Sierra-Lobo/mtdb-hw/revA/doc/mtdc-revA-pcb-bot.JPG

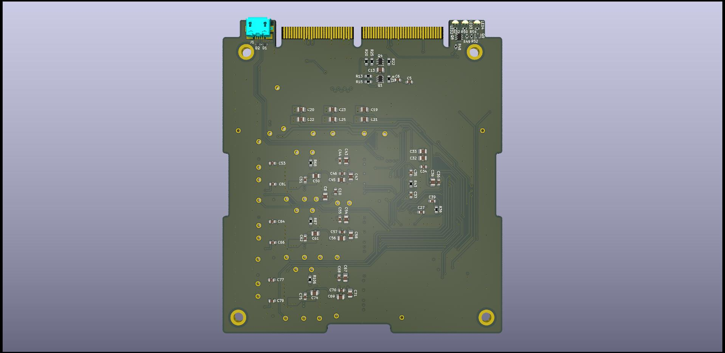
revA/doc/mtdc-revA-pcb-bot.JPG
