Sierra-Lobo/mtdb-hw/revA/doc/mtdc-revA-bom.xlsx

Item | Qty | Reference(s) | Value | DNP | Description | Manufacturer | Mfr. Part No | LibPart | Footprint | Datasheet
1 | 35 | C1, C2, C3, C4, C5, C6, C9, C10, C12, C14, C15, C27, C30, C31, C34, C35, C36, C37, C39, C42, C44, C51, C53, C55, C62, C64, C65, C66, C68, C75, C77, C78, C79, C80, C81 | 0.1uF |  | CAP CER 0.1UF 50V X7R 0603 | TDK Corporation | CGA3E2X7R1H104K080AE | Device:C | Capacitor_SMD:C_0603_1608Metric | https://product.tdk.com/en/system/files
2 | 13 | C7, C8, C19, C20, C21, C22, C23, C24, C25, C33, C50, C61, C74 | 1uF |  | CAP CER 1UF 50V X7R 0805 | TDK Corporation | CGA4J3X7R1H105K125AE | Device:C | Capacitor_SMD:C_0805_2012Metric | https://product.tdk.com/en/system/files
3 | 10 | C11, C13, C26, C32, C38, C40, C41, C43, C54, C67 | 10uF |  | CAP CER 10UF 25V X7S 0805 | TDK Corporation | CGA4J1X7S1E106K125AE | Device:C | Capacitor_SMD:C_0805_2012Metric | https://product.tdk.com/en/system/files
4 | 1 | C16 | 47uF |  | CAP CER 47UF 25V X5R 1206 | TDK | C3216X5R1E476M160AC | Device:C | Capacitor_SMD:C_1206_3216Metric | https://product.tdk.com/system/files/dam/doc/product/capacitor/ceramic/mlcc/catalog/mlcc_commercial_general_en.pdf
5 | 2 | C17, C18 | 47uF |  | CAP TANT 47UF 10% 16V 2917 | Vishay Sprague | TH3D476K016C0600 | Device:C_Polarized_US | Capacitor_Tantalum_SMD:CP_EIA-7343-43_Kemet-X | https://www.vishay.com/docs/40084/th3.pdf
6 | 2 | C28, C29 | 8pF |  | CAP CER 8PF 50V NP0 0402 | TDK Corporation | CGA2B2NP01H080D050BA | Device:C | Capacitor_SMD:C_0402_1005Metric | https://product.tdk.com/en/system/files
7 | 3 | C45, C56, C69 | 10uF | DNP | CAP CER 10UF 25V X7S 0805 | TDK Corporation | CGA4J1X7S1E106K125AE | Device:C | Capacitor_SMD:C_0805_2012Metric | https://product.tdk.com/en/system/files
8 | 3 | C46, C57, C70 | 0.1uF | DNP | CAP CER 0.1UF 50V X7R 0603 | TDK Corporation | CGA3E2X7R1H104K080AE | Device:C | Capacitor_SMD:C_0603_1608Metric | https://product.tdk.com/en/system/files
9 | 3 | C47, C58, C71 | 1uF | DNP | CAP CER 1UF 50V X7R 0805 | TDK Corporation | CGA4J3X7R1H105K125AE | Device:C | Capacitor_SMD:C_0805_2012Metric | https://product.tdk.com/en/system/files
10 | 6 | C48, C52, C59, C63, C72, C76 | 22uF |  | CAP CER 22UF 16V X7R 1210 | TDK Corporation | CGA6P1X7R1C226M250AC | Device:C | Capacitor_SMD:C_1210_3225Metric | https://product.tdk.com/system/files/dam/doc/product/capacitor/ceramic/mlcc/catalog/mlcc_automotive_general_en.pdf
11 | 3 | C49, C60, C73 | 100pF |  | CAP CER 100PF 50V NP0 0603 | TDK Corporation | CGA3E2C0G1H101J080AE | Device:C | Capacitor_SMD:C_0603_1608Metric | https://product.tdk.com/en/system/files
12 | 2 | D1, D2 | ESD321DPYR |  | TVS DIODE 3.6VWM 6.8VC 2X1SON | Texas Instruments | ESD321DPYR | Device:D_Zener | SierraLobo:D_0402_1005Metric | https://www.ti.com/general/docs/suppproductinfo.tsp?distId=10
13 | 2 | D3, D4 | 1N4148W-13-F |  | DIODE GEN PURP 100V 300MA SOD123 | Diodes Incorporated | 1N4148W-13-F | Device:D | Diode_SMD:D_SOD-123 | https://www.diodes.com/assets/Datasheets/BAV16W_1N4148W.pdf
14 | 1 | D5 | SK6812MINI |  | ADDRESS LED DISC SERIAL RGB 1=10 | Adafruit Industries LLC | 2659 | LED:SK6812MINI | LED_SMD:LED_SK6812MINI_PLCC4_3.5x3.5mm_P1.75mm | https://cdn-shop.adafruit.com/product-files/2686/SK6812MINI_REV.01-1-2.pdf
16 | 1 | J1 | ZX62-AB-5PA(31) |  | CONN RCPT USB2.0 MICRO AB SMD RA | Hirose Electric | ZX62-AB-5PA(31) | Connector:USB_B_Micro | SierraLobo:ZX62-AB-5PA(31) | https://www.hirose.com/product/document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
17 | 6 | J2, J3, J4, J5, J6, J7 | T1M-02-F-SH-L |  | CONN HEADER SMD R/A 2POS 1MM | Samtec | T1M-02-F-SH-L-K | Connector_Generic:Conn_01x02 | SierraLobo:SAMTEC_T1M-02-F-SH-L-K | https://suddendocs.samtec.com/prints/t1m-xx-x-sh-l-x-xx-mkt.pdf
18 | 1 | JP1 | Wire Cut Jumper |  | 26 AWG SOLID CORE WIRE | N/A | N/A | Jumper:Jumper_2_Bridged | Resistor_SMD:R_0603_1608Metric | ~
19 | 1 | L1 | 10uH |  | FIXED IND WW SHEILD 10UH 1.72A 230MOHM 1210 | TDK | BCL322520RT-100M-D | Device:L | Inductor_SMD:L_1210_3225Metric | https://product.tdk.com/system/files/dam/doc/product/inductor/inductor/smd/catalog/inductor_automotive_power_bcl322520rt-d_en.pdf
20 | 3 | L2, L3, L4 | 2.2uH |  | FIXED IND 2.2UH 6.6A 26MOHM SMD | Vishay Dale | IHLP2020CZER2R2M8A | Device:L | SierraLobo:L_Vishay_IHLP-2020 | https://www.vishay.com/docs/34563/ihlp-2020cz-8a.pdf
21 | 1 | LED1 | GREEN |  | LED GREEN CLEAR SMD R/A | Kingbright | APA2107CGCK | Device:D | SierraLobo:APA2107x | https://www.kingbrightusa.com/images/catalog/SPEC/APA2107CGCK.pdf
22 | 1 | LED2 | ORANGE |  | LED ORANGE CLEAR SMD R/A | Kingbright | APA2107SECK | Device:D | SierraLobo:APA2107x | https://www.kingbrightusa.com/images/catalog/SPEC/APA2107SECK.pdf
23 | 1 | LED3 | YELLOW |  | LED YELLOW CLEAR SMD R/A | Kingbright | APA2107SYCK | Device:D | SierraLobo:APA2107x | https://www.kingbrightusa.com/images/catalog/SPEC/APA2107SYCK.pdf
24 | 1 | LED4 | RED |  | LED RED CLEAR SMD R/A | Kingbright | APA2107LSECK/J3-PRV | Device:D | SierraLobo:APA2107x | https://www.kingbrightusa.com/images/catalog/SPEC/APA2107LSECK-J3-PRV.pdf
25 | 3 | NTC1, NTC2, NTC3 | 10k |  | THERMISTOR NTC 10KOHM 3976K BEAD | TE | GA10K3A1AM | Device:Thermistor_NTC_US |  | https://www.te.com/usa-en/product-GA10K3A1AM.datasheet.pdf
26 | 1 | P2 | Conn_01x06 |  | CONN HEADER SMD 36POS 2.54MM | Samtec | TSM-136-01-L-SV | Connector_Generic:Conn_01x06 | Connector_PinHeader_2.54mm:PinHeader_1x06_P2.54mm_Vertical_SMD_Pin1Right | https://suddendocs.samtec.com/catalog_english/tsm.pdf
27 | 1 | P3 | Conn_02x03_Odd_Even |  | CONN HEADER SMD 52POS 2.54MM | Samtec | TSM-126-02-L-DV-P-TR | Connector_Generic:Conn_02x03_Odd_Even | Connector_PinHeader_2.54mm:PinHeader_2x03_P2.54mm_Vertical_SMD | https://suddendocs.samtec.com/catalog_english/tsm.pdf
28 | 1 | P4 | FTSH-105-01-F-DV-K-TR |  | CONN HEADER SMD 10POS 1.27MM | Samtec | FTSH-105-01-F-DV-K-TR | Connector_Generic:Conn_02x05_Odd_Even | Connector_PinHeader_1.27mm:PinHeader_2x05_P1.27mm_Vertical_SMD | https://suddendocs.samtec.com/catalog_english/ftsh_smt.pdf
29 | 4 | Q1, Q4, Q7, Q8 | MMDT2222A |  | TRANS 2NPN 40V 0.6A SOT363 | Diodes Incorporated | MMDT2222A-7-F | SierraLobo:MMDT2222 | Package_TO_SOT_SMD:SOT-363_SC-70-6 | https://www.diodes.com/assets/Datasheets/ds30125.pdf
30 | 1 | Q2 | IRLML2803 |  | MOSFET N-CH 30V 1.2A SOT23 | Infineon | IRLML2803TRPBF | Device:Q_NMOS_GSD | Package_TO_SOT_SMD:SOT-23 | https://www.infineon.com/dgdl/irlml2803pbf.pdf?fileId=5546d462533600a4015356682aff260f
31 | 1 | Q3 | MMBT4401WT1G |  | TRANS NPN 40V 0.6A SC70-3 | onsemi | TRANS NPN 40V 0.6A SC70-3 | Device:Q_NPN_BEC | Package_TO_SOT_SMD:SOT-323_SC-70 | https://www.onsemi.com/pdf/datasheet/mmbt4401wt1-d.pdf
32 | 2 | Q5, Q6 | BSZ180 |  | MOSFET P-CH 30V 9A/39.6A TSDSON | Infineon | BSZ180P03NS3GATMA1 | SierraLobo:BSZ086 | SierraLobo:PG-TSDSON-8_3.3x3.3mm | https://www.infineon.com/dgdl/Infineon-BSZ180P03NS3_G-DS-v02_01-en.pdf?fileId=db3a304326dfb13001271f04398f4ec1
33 | 1 | Q9 | MMBT3906T |  | TRANS PNP 40V 0.2A SOT523 | Diodes Incorporated | MMBT3906T-7-F | Device:Q_PNP_BEC | Package_TO_SOT_SMD:SOT-523 | https://www.diodes.com/assets/Datasheets/ds30271.pdf
34 | 10 | R1, R4, R44, R46, R64, R69, R83, R88, R102, R107 | 0 |  | RES 0 OHM JUMPER 1/10W 0603 | Stackpole Electronics Inc | RMCF0603ZT0R00 | Device:R_US | Resistor_SMD:R_0603_1608Metric | https://www.seielect.com/Catalog/SEI-RMCF_RMCP.pdf
35 | 5 | R2, R3, R65, R84, R103 | 0 | DNP | RES 0 OHM JUMPER 1/10W 0603 | Stackpole Electronics Inc | RMCF0603ZT0R00 | Device:R_US | Resistor_SMD:R_0603_1608Metric | https://www.seielect.com/Catalog/SEI-RMCF_RMCP.pdf
36 | 26 | R5, R6, R16, R23, R24, R45, R47, R51, R59, R60, R61, R71, R72, R73, R78, R79, R80, R90, R91, R92, R97, R98, R99, R109, R110, R111 | 1k |  | RES 1K OHM 1% 1/10W 0603 | Stackpole Electronics Inc | RMCF0603FG1K00 | Device:R_US | Resistor_SMD:R_0603_1608Metric | https://www.seielect.com/Catalog/SEI-RMCF_RMCP.pdf
37 | 2 | R7, R8 | 220 |  | RES 220 OHM 1% 1/10W 0603 | Stackpole Electronics Inc | RMCF0603FT220R | Device:R_US | Resistor_SMD:R_0603_1608Metric | https://www.seielect.com/Catalog/SEI-RMCF_RMCP.pdf
38 | 19 | R9, R14, R15, R17, R18, R22, R43, R66, R67, R68, R70, R85, R86, R87, R89, R104, R105, R106, R108 | 100k |  | RES 100K OHM 1% 1/10W 0603 | Stackpole Electronics Inc | RMCF0603FT100K | Device:R_US | Resistor_SMD:R_0603_1608Metric | https://www.seielect.com/Catalog/SEI-RMCF_RMCP.pdf
39 | 16 | R10, R11, R12, R13, R19, R26, R27, R34, R36, R37, R40, R41, R42, R62, R81, R100 | 10k |  | RES 10K OHM 1% 1/10W 0603 | Stackpole Electronics Inc | RMCF0603FT10K0 | Device:R_US | Resistor_SMD:R_0603_1608Metric | https://www.seielect.com/Catalog/SEI-RMCF_RMCP.pdf
40 | 1 | R20 | 200k |  | RES 200K OHM 1% 1/10W 0603 | Stackpole Electronics Inc | RMCF0603FT200K | Device:R_US | Resistor_SMD:R_0603_1608Metric | https://www.seielect.com/Catalog/SEI-RMCF_RMCP.pdf
41 | 1 | R21 | 20k |  | RES 20K OHM 1% 1/10W 0603 | Stackpole Electronics Inc | RMCF0603FT20K0 | Device:R_US | Resistor_SMD:R_0603_1608Metric | https://www.seielect.com/Catalog/SEI-RMCF_RMCP.pdf
42 | 1 | R25 | 73.2k |  | RES 73.2K OHM 1% 1/10W 0603 | Stackpole Electronics Inc | RMCF0603FT73K2 | Device:R_US | Resistor_SMD:R_0603_1608Metric | https://www.seielect.com/Catalog/SEI-RMCF_RMCP.pdf
43 | 1 | R28 | 12.4k |  | RES 12.4K OHM 1% 1/10W 0603 | Stackpole Electronics Inc | RMCF0603FT12K4 | Device:R_US | Resistor_SMD:R_0603_1608Metric | https://www.seielect.com/Catalog/SEI-RMCF_RMCP.pdf
44 | 1 | R29 | 4.12k |  | RES 4.12K OHM 1% 1/10W 0603 | Stackpole Electronics Inc | RMCF0603FT4K12 | Device:R_US | Resistor_SMD:R_0603_1608Metric | https://www.seielect.com/Catalog/SEI-RMCF_RMCP.pdf
45 | 4 | R30, R32, R50, R54 | 1.5k |  | RES 1.5K OHM 1% 1/16W 0402 | Stackpole Electronics Inc | RMCF0402FT1K50 | Device:R_US | Resistor_SMD:R_0402_1005Metric | https://www.seielect.com/Catalog/SEI-RMCF_RMCP.pdf
46 | 5 | R31, R33, R48, R49, R52 | 10k |  | RES 10K OHM 1% 1/16W 0402 | Stackpole Electronics Inc | RMCF0402FT10K0 | Device:R_US | Resistor_SMD:R_0402_1005Metric | https://www.seielect.com/Catalog/SEI-RMCF_RMCP.pdf
47 | 1 | R35 | 330 |  | RES 330 OHM 1% 1/10W 0603 | Stackpole Electronics Inc | RMCF0603FT330R | Device:R_US | Resistor_SMD:R_0603_1608Metric | https://www.seielect.com/Catalog/SEI-RMCF_RMCP.pdf
48 | 1 | R38 | 330k |  | RES 330K OHM 1% 1/10W 0603 | Stackpole Electronics Inc | RMCF0603FT330K | Device:R_US | Resistor_SMD:R_0603_1608Metric | https://www.seielect.com/Catalog/SEI-RMCF_RMCP.pdf
49 | 1 | R39 | 110k |  | RES 110K OHM 1% 1/10W 0603 | Stackpole Electronics Inc | RMCF0603FT110K | Device:R_US | Resistor_SMD:R_0603_1608Metric | https://www.seielect.com/Catalog/SEI-RMCF_RMCP.pdf
50 | 4 | R53, R63, R82, R101 | 10k | DNP | RES 10K OHM 1% 1/10W 0603 | Stackpole Electronics Inc | RMCF0603FT10K0 | Device:R_US | Resistor_SMD:R_0603_1608Metric | https://www.seielect.com/Catalog/SEI-RMCF_RMCP.pdf
51 | 2 | R55, R74 | 300mR |  | RES 0.3 OHM 1% 1/4W 0805 | Vishay Dale | RCWE0805R300FKEA | Device:R_US | Resistor_SMD:R_0805_2012Metric | https://www.vishay.com/docs/20019/rcwe.pdf
52 | 9 | R56, R57, R58, R75, R76, R77, R94, R95, R96 | 1k | DNP | RES 1K OHM 1% 1/10W 0603 | Stackpole Electronics Inc | RMCF0603FG1K00 | Device:R_US | Resistor_SMD:R_0603_1608Metric | https://www.seielect.com/Catalog/SEI-RMCF_RMCP.pdf
53 | 1 | R93 | 100mR |  | RES 0.1 OHM 1% 1/4W 0805 | Vishay Dale | RCWE0805R100FKEA | Device:R_US | Resistor_SMD:R_0805_2012Metric | https://www.vishay.com/docs/20019/rcwe.pdf
54 | 1 | SW1 | KMR231NG LFS |  | SWITCH TACTILE SPST-NO 0.05A 32V | C&K | KMR231NG LFS | Switch:SW_SPST | SierraLobo:KMR2_4.6X2.8 | https://www.ckswitches.com/media/1479/kmr2.pdf
55 | 3 | TP1, TP2, TP3 | ${NET_NAME(1)} |  | PC TEST POINT MINIATURE | Keystone | 5027 | Connector:TestPoint | SierraLobo:Keystone_5027 | https://www.keyelco.com/userAssets/file/M65p55.pdf
56 | 35 | TP4, TP5, TP6, TP7, TP8, TP9, TP10, TP11, TP12, TP13, TP14, TP15, TP16, TP17, TP18, TP19, TP20, TP21, TP22, TP23, TP24, TP25, TP26, TP27, TP28, TP29, TP30, TP31, TP32, TP33, TP34, TP35, TP36, TP37, TP38 | ${NET_NAME(1)} |  | PC TEST POINT MINIATURE PURPLE | Keystone | 5119 | Connector:TestPoint | SierraLobo:TestPoint_Keystone_5000-5004_Miniature | https://www.keyelco.com/userAssets/file/M65p56.pdf
57 | 2 | U1, U2 | 74LVC1G17 |  | IC BUF NON-INVERT 5.5V SC70-5 | Texas Instruments | SN74LVC1G17QDCKRQ1 | SierraLobo:74LVC1G17 | Package_TO_SOT_SMD:SOT-353_SC-70-5 | https://www.ti.com/lit/ds/symlink/sn74lvc1g17.pdf
58 | 2 | U3, U4 | MCP9700Ax-E/LT |  | SENSOR ANALOG -40C-125C SC70-5 | Microchip Technology | MCP9700AT-E/LT | SierraLobo:MCP9700Ax-E/LT | Package_TO_SOT_SMD:SOT-353_SC-70-5 | http://ww1.microchip.com/downloads/en/DeviceDoc/20001942G.pdf
59 | 1 | U5 | AP2161W |  | IC PWR SWITCH P-CHAN 1:1 SOT25 | Diodes Incorporated | AP2161W | Power_Management:AP2161W | Package_TO_SOT_SMD:SOT-23-5 | https://www.diodes.com/assets/Datasheets/AP2161.pdf
60 | 2 | U6, U7 | MCP1700T-33 |  | IC REG LINEAR 3.3V 250MA SOT89-3 | Microchip Technology | MCP1700T-3302E/MB | Regulator_Linear:MCP1700x-330xxMB | Package_TO_SOT_SMD:SOT-89-3 | http://ww1.microchip.com/downloads/en/DeviceDoc/20001826D.pdf
61 | 1 | U8 | MCP1700T-50 |  | IC REG LINEAR 5.0V 250MA SOT89-3 | Microchip Technology | MCP1700T-5002E/MB | Regulator_Linear:MCP1700x-330xxMB | Package_TO_SOT_SMD:SOT-89-3 | http://ww1.microchip.com/downloads/en/DeviceDoc/20001826D.pdf
62 | 1 | U9 | ATL431 |  | IC VREF SHUNT ADJ 0.5% SOT23-3 | Texas Instruments | ATL431BQDBZR | SierraLobo:ATL31BQDBZR | Package_TO_SOT_SMD:SOT-23 | https://www.ti.com/lit/ds/slvs555m/slvs555m.pdf?ts=1687216345649
63 | 1 | U10 | MAX708RESA+T |  | IC SUPERVISOR 1 CHANNEL 8SOIC | Analog Devices/Maxim Integrated | MAX708RESA+T | SierraLobo:MAX708RESA | Package_SO:SO-8_3.9x4.9mm_P1.27mm | https://www.analog.com/media/en/technical-documentation/data-sheets/max706ap-max708t.pdf
64 | 1 | U11 | MR25H10MDF |  | IC RAM 1MBIT SPI 40MHZ 8DFN | Everspin Technologies Inc. | MR25H10MDF | SierraLobo:MR25H10MDF | Package_DFN_QFN:DFN-8-1EP_6x5mm_P1.27mm_EP2x2mm | https://www.mouser.com/datasheet/2/144/MR25H10_Datasheet-1511337.pdf
65 | 1 | U12 | ATSAMD51J20A-AU |  | IC MCU 32BIT 1MB FLASH 64TQFP | Microchip Technology | ATSAMD51J20A-AU | SierraLobo:ATSAMD51J20A-AU | Package_QFP:TQFP-64_10x10mm_P0.5mm | http://ww1.microchip.com/downloads/en/DeviceDoc/60001507E.pdf
66 | 3 | U13, U17, U22 | DAC121S101Q |  | IC DAC 12BIT V-OUT TSOT23-6 | Texas Instruments | DAC121S101QCMK/NOPB | SierraLobo:DAC121S101Q | Package_TO_SOT_SMD:TSOT-23-6 | https://www.ti.com/lit/ds/symlink/dac121s101.pdf?HQS=dis-dk-null-digikeymode-dsf-pf-null-wwe&ts=1686947453484
67 | 3 | U14, U18, U23 | AD5270BRM | DNP | IC DGT RHE 100KOHM 1024TP 10MSOP | Analog Devices | AD5270BRMZ-100 | SierraLobo:AD5270BRM | Package_SO:MSOP-10_3x3mm_P0.5mm | https://www.analog.com/media/en/technical-documentation/data-sheets/AD5270_5271.pdf
68 | 3 | U15, U19, U24 | LTC3600 |  | IC REG BUCK PROG 1.5A 12MSOP | Analog Devices | LTC3600EMSE#TRPBF | SierraLobo:LTC3600EMSE | Package_SO:MSOP-12-1EP_3x4mm_P0.65mm_EP1.65x2.85mm | https://www.analog.com/media/en/technical-documentation/data-sheets/3600fd.pdf
69 | 3 | U16, U20, U25 | DRV8838 |  | IC BRIDGE DRIVER PAR 8WSON | Texas Instruments | DRV8838DSGT | SierraLobo:DRV8838DSGT | Package_SON:WSON-8-1EP_2x2mm_P0.5mm_EP0.9x1.6mm | https://www.ti.com/general/docs/suppproductinfo.tsp?distId=10
70 | 3 | U21, U26, U27 | INA199A2 |  | IC CURRENT SENSE 1.5% SC70-6 | Texas Instruments | INA199A2DCKT | Amplifier_Current:INA199xxDCK | Package_TO_SOT_SMD:SOT-363_SC-70-6 | http://www.ti.com/lit/ds/symlink/ina199.pdf
71 | 1 | Y1 | 32.768kHz |  | CRYSTAL 32.7680KHZ 12.5PF SMD | Abracon | ABS07AIG-32.768KHZ-1-T | Device:Crystal | SierraLobo:Crystal_SMD_3215-2Pin_3.2x1.5mm | https://abracon.com/datasheets/ABS07AIG.pdf
Total | 295 | 70 |  |  |  |  |  |  |  | 70
