Sierra-Lobo/mtdb-hw/revA/doc/mtdc-revA-sch.pdf

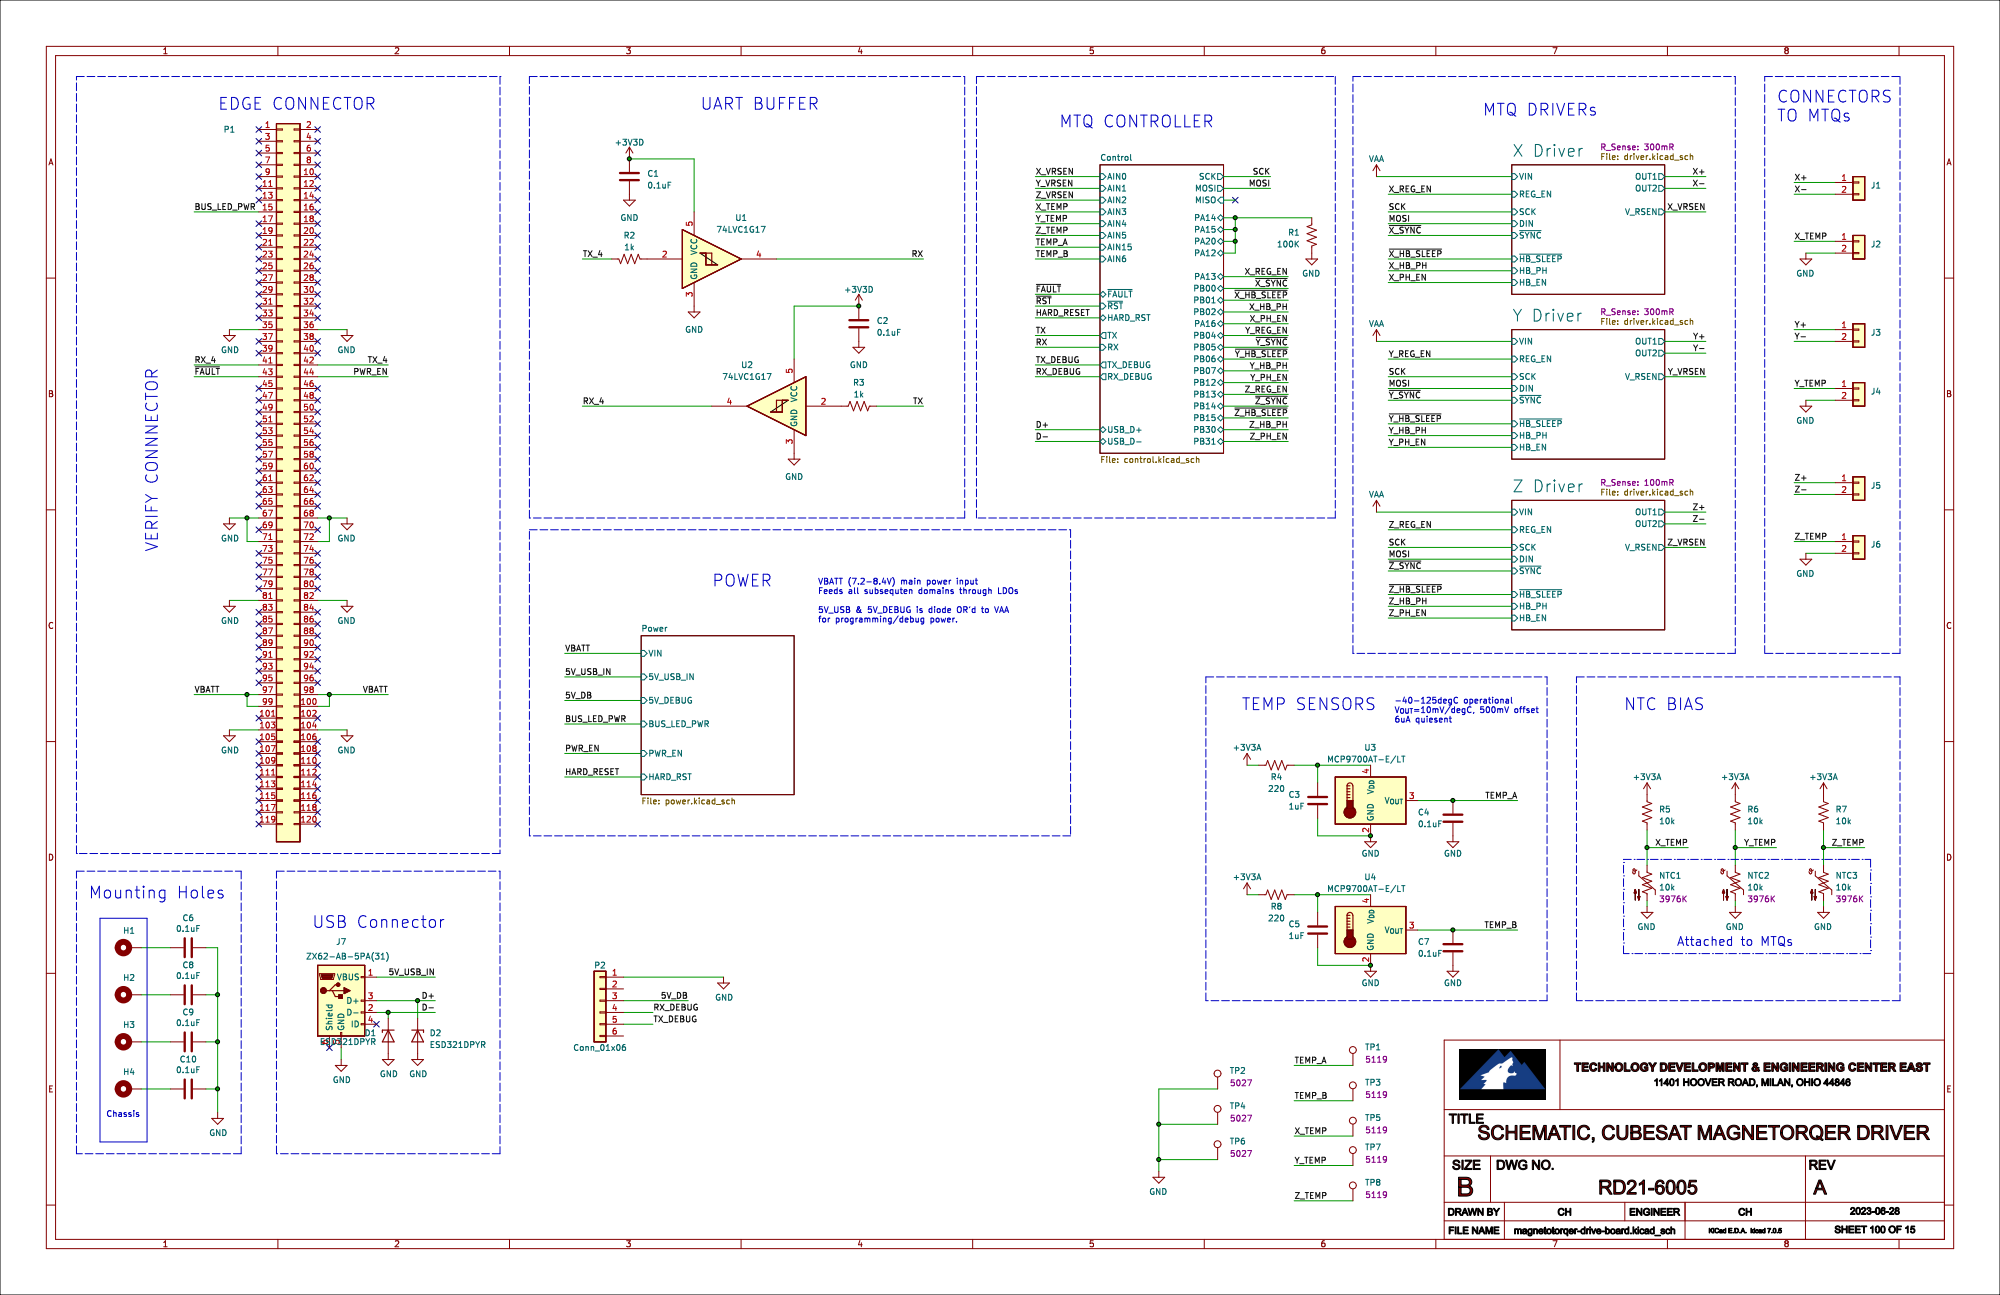
[picture p21: page 1]

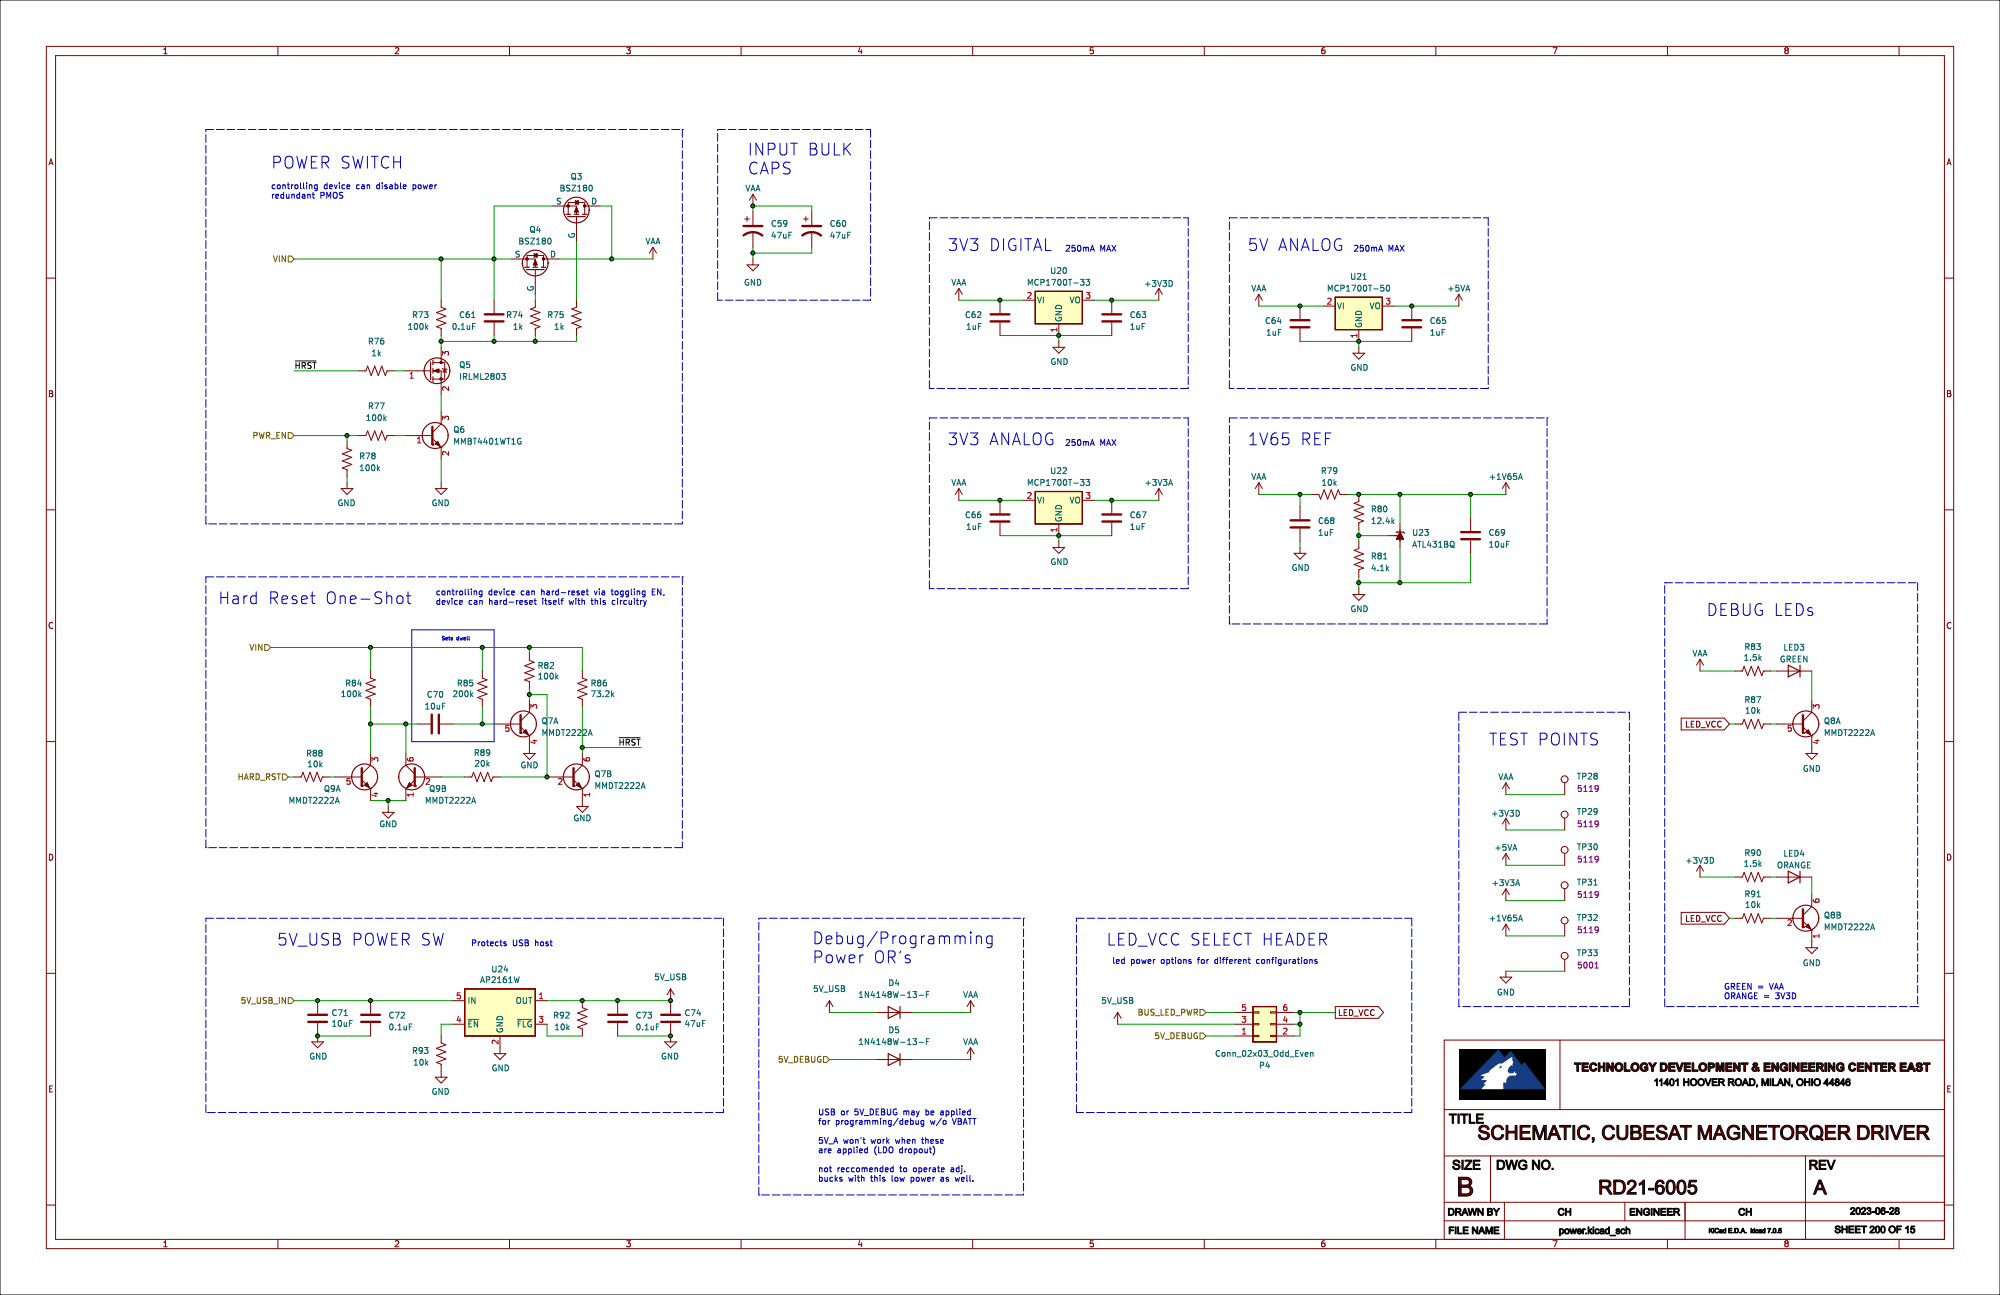
[picture p22: page 2]

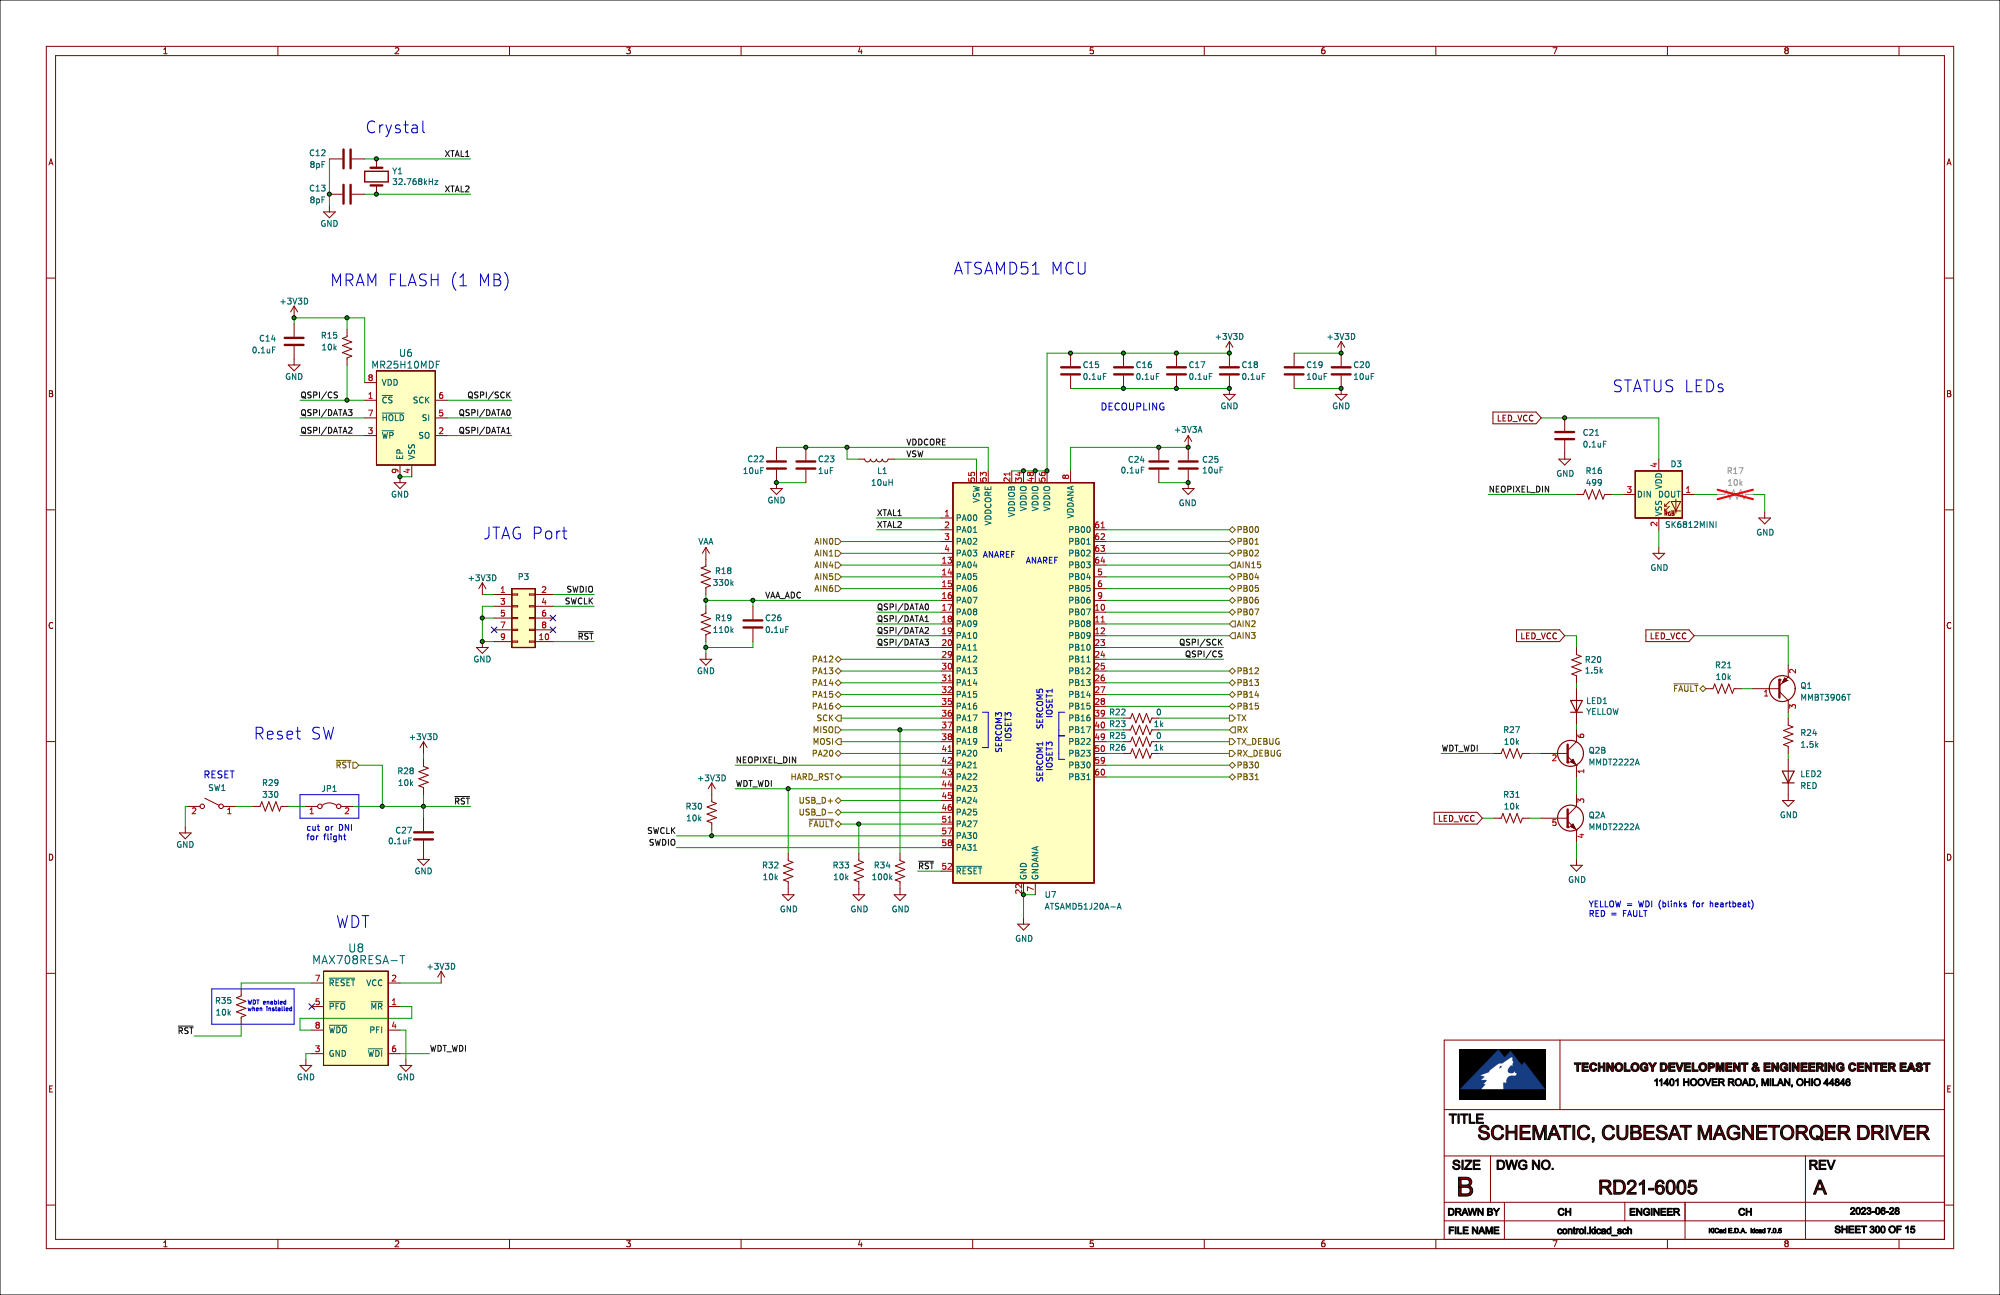
[picture p23: page 3]

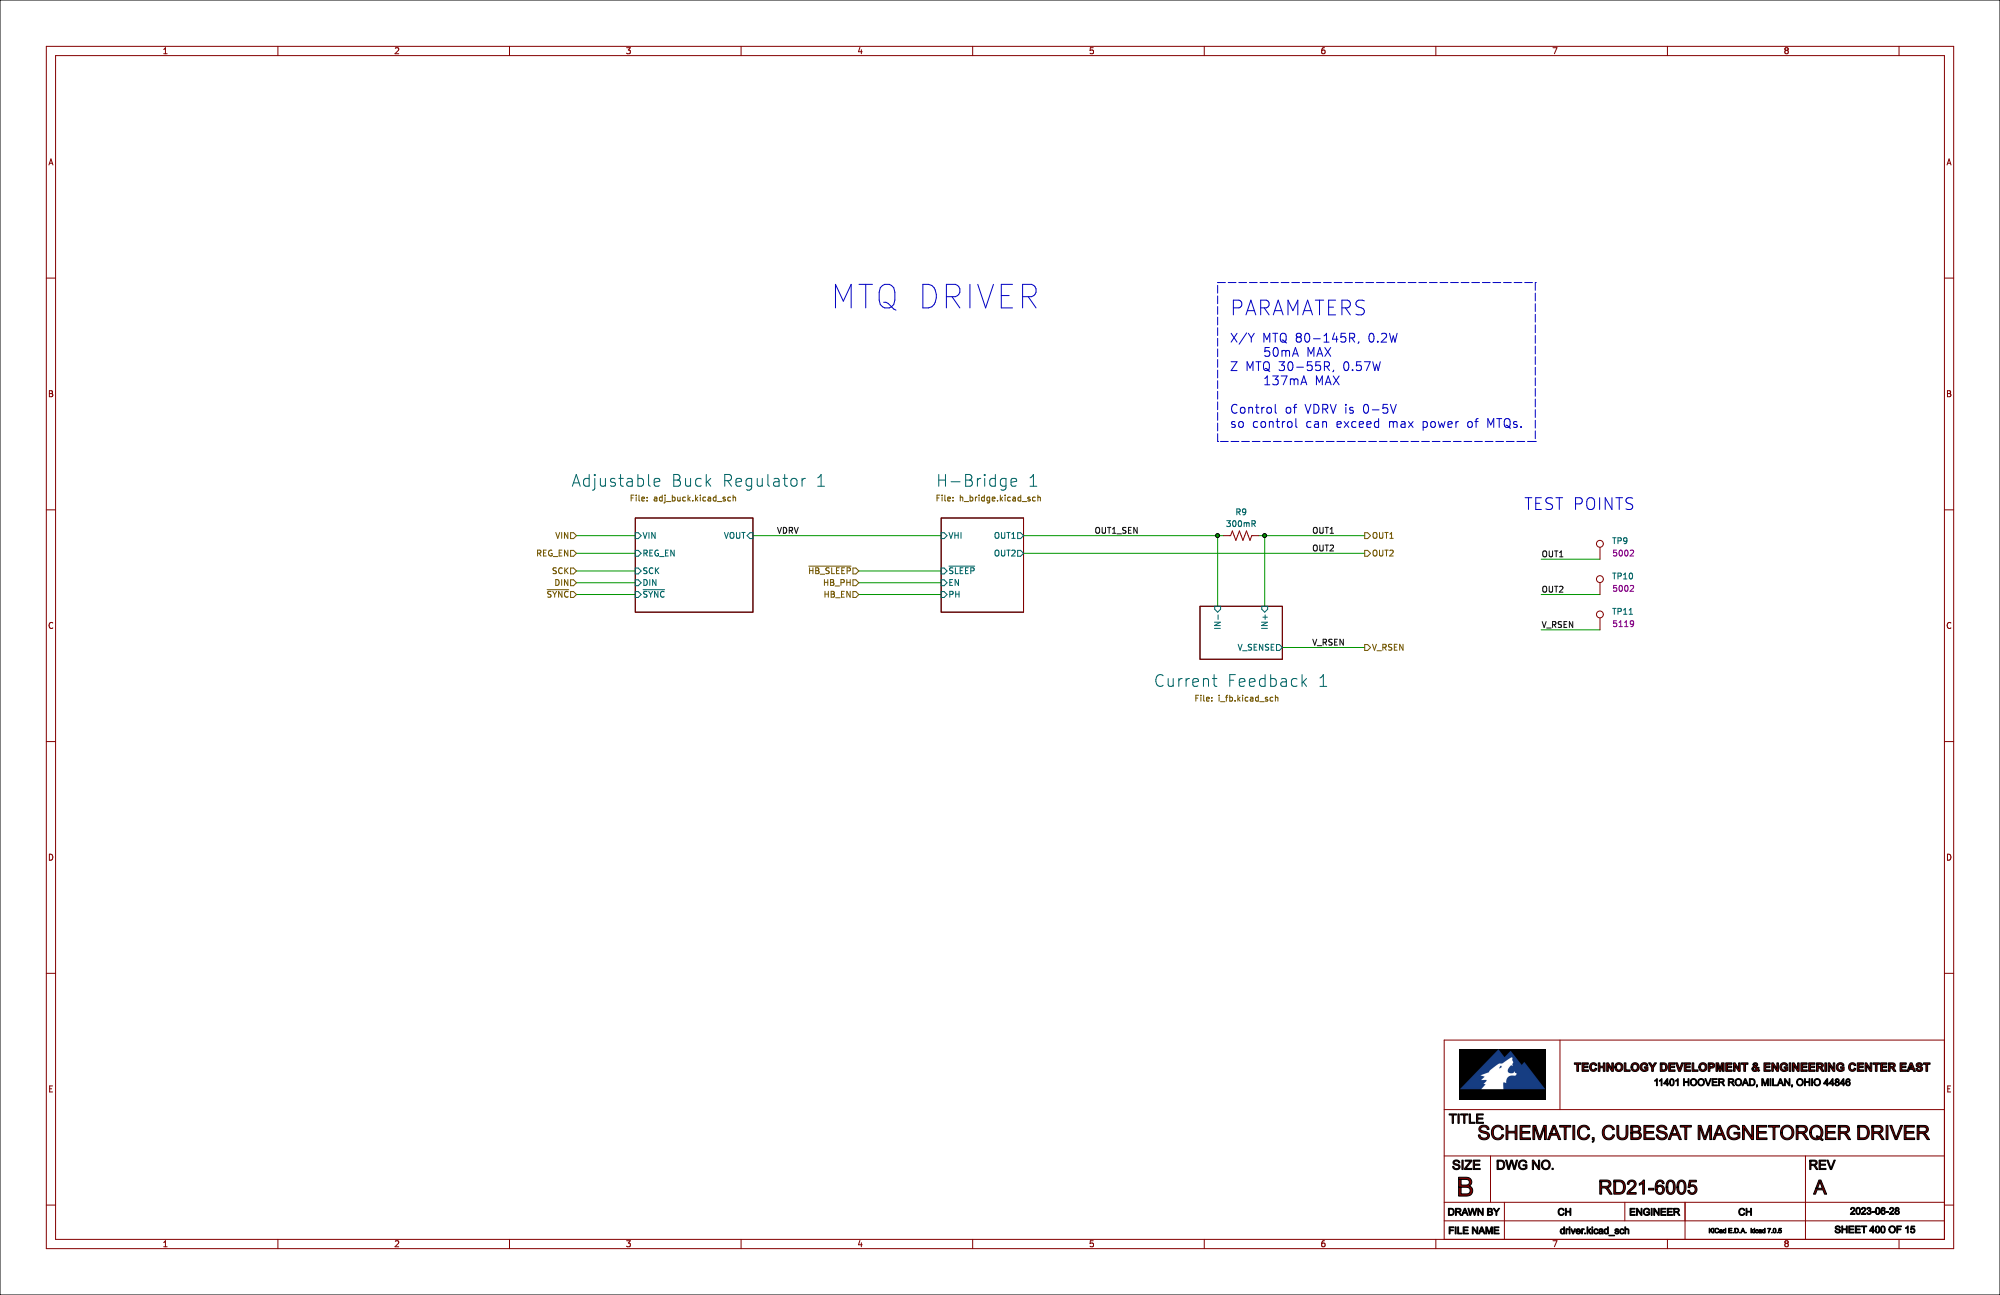
[picture p24: page 4]

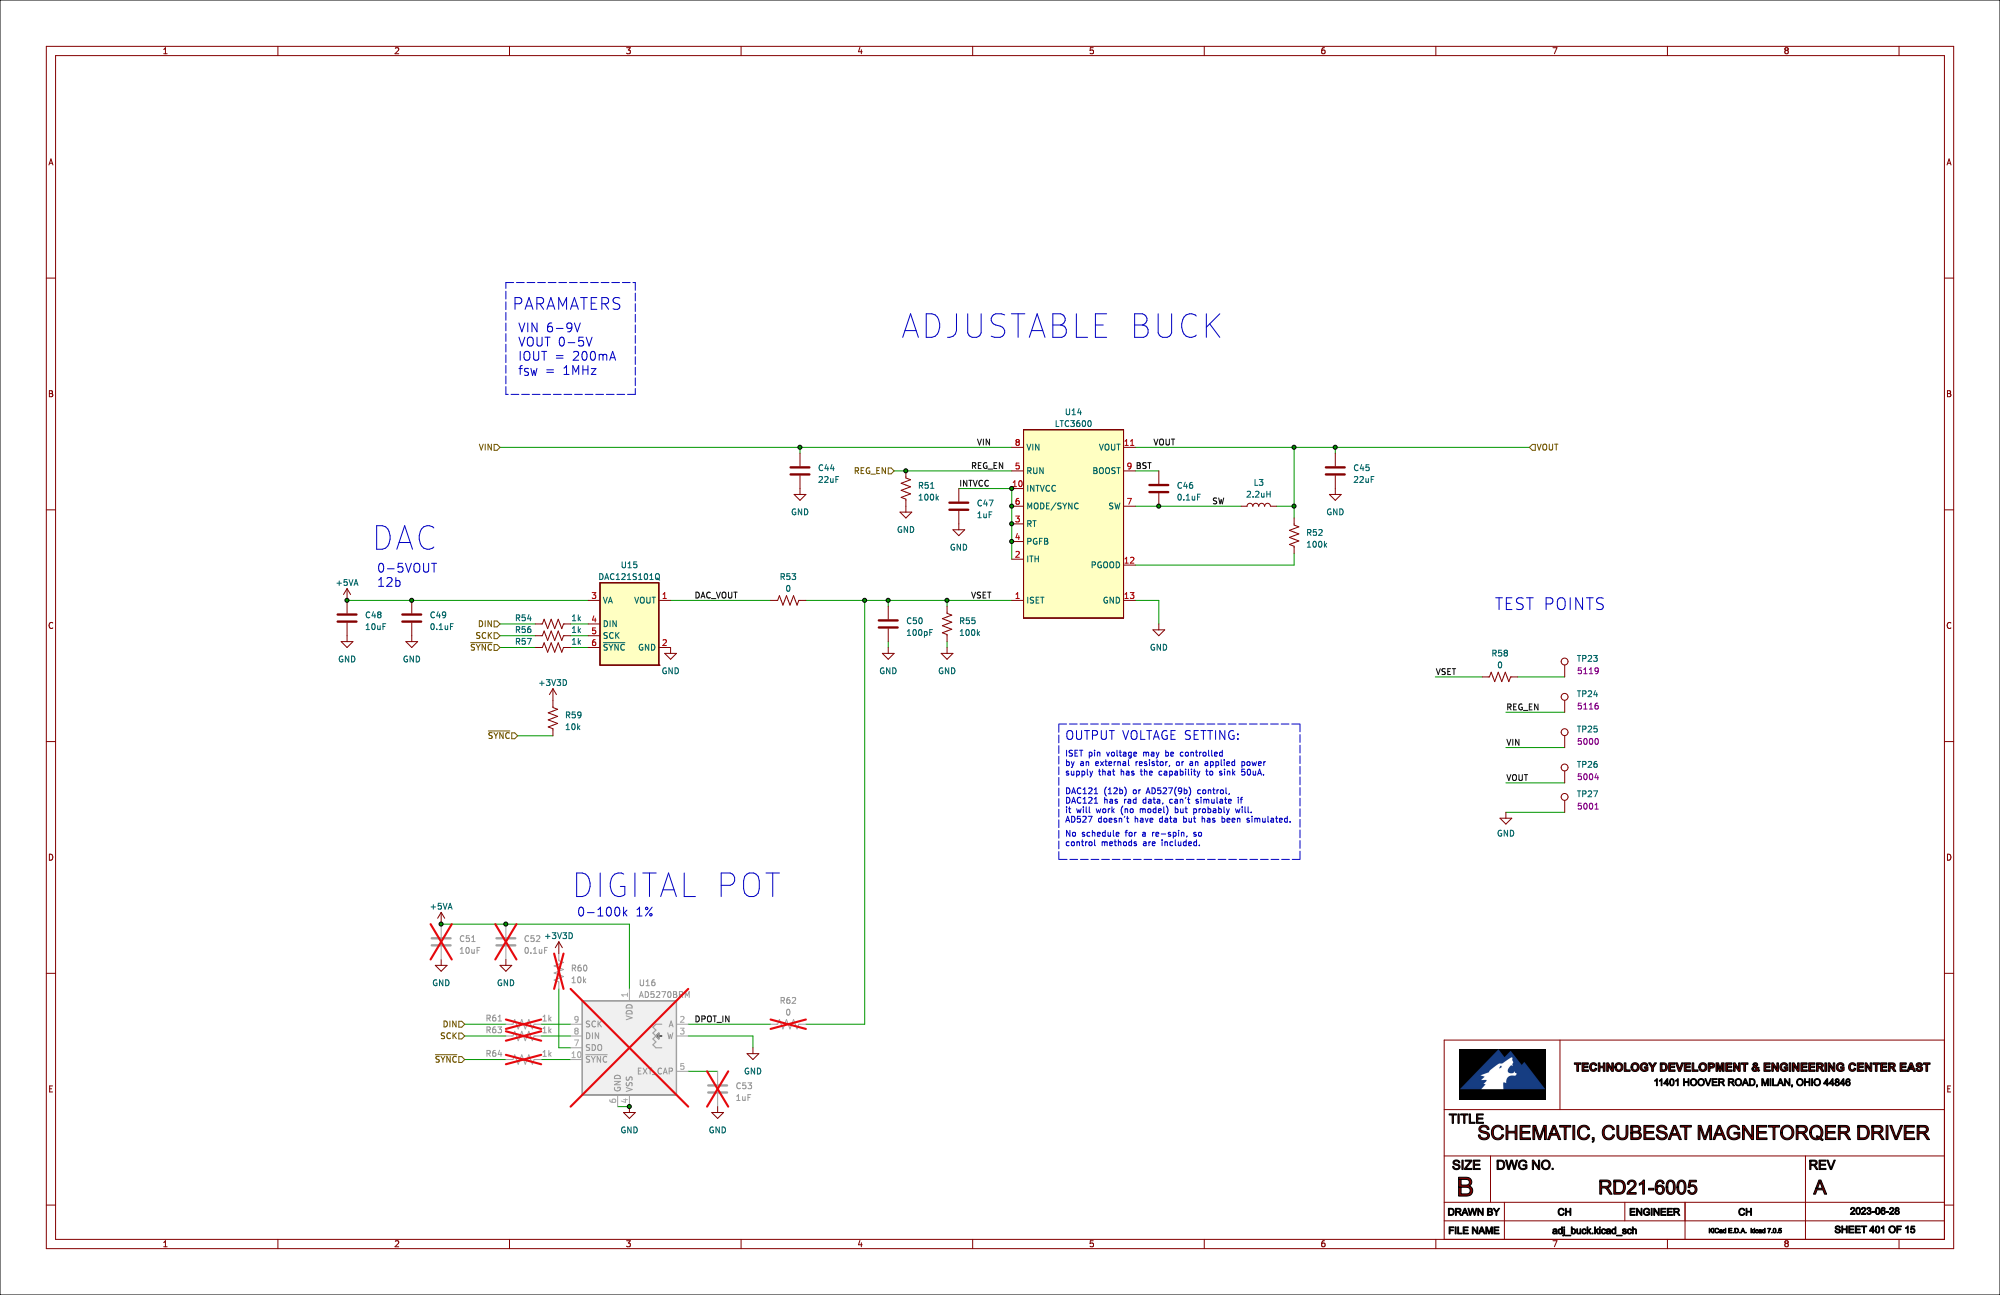
[picture p25: page 5]

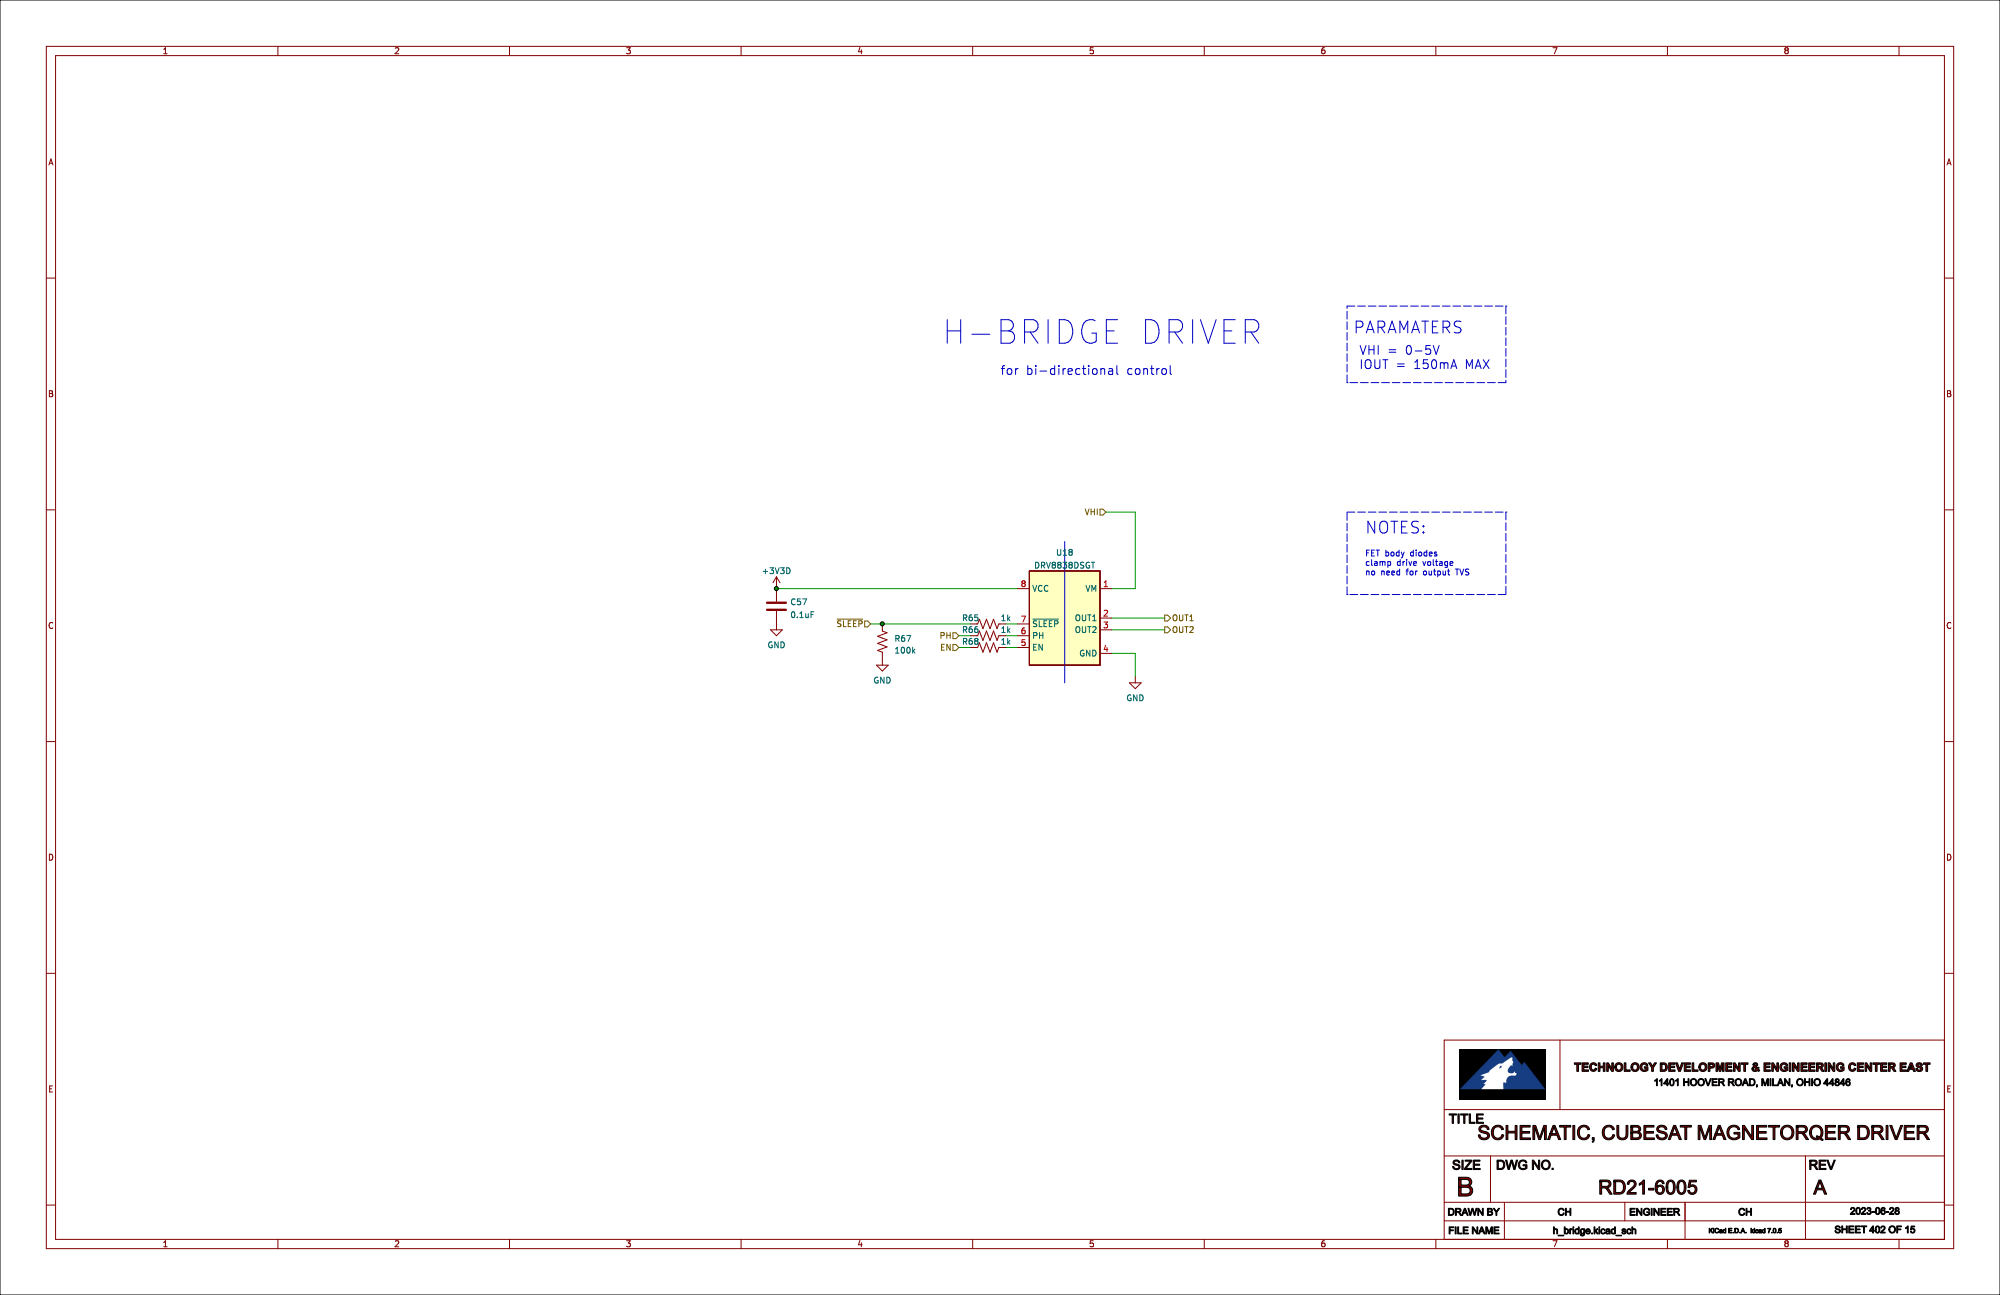
[picture p26: page 6]

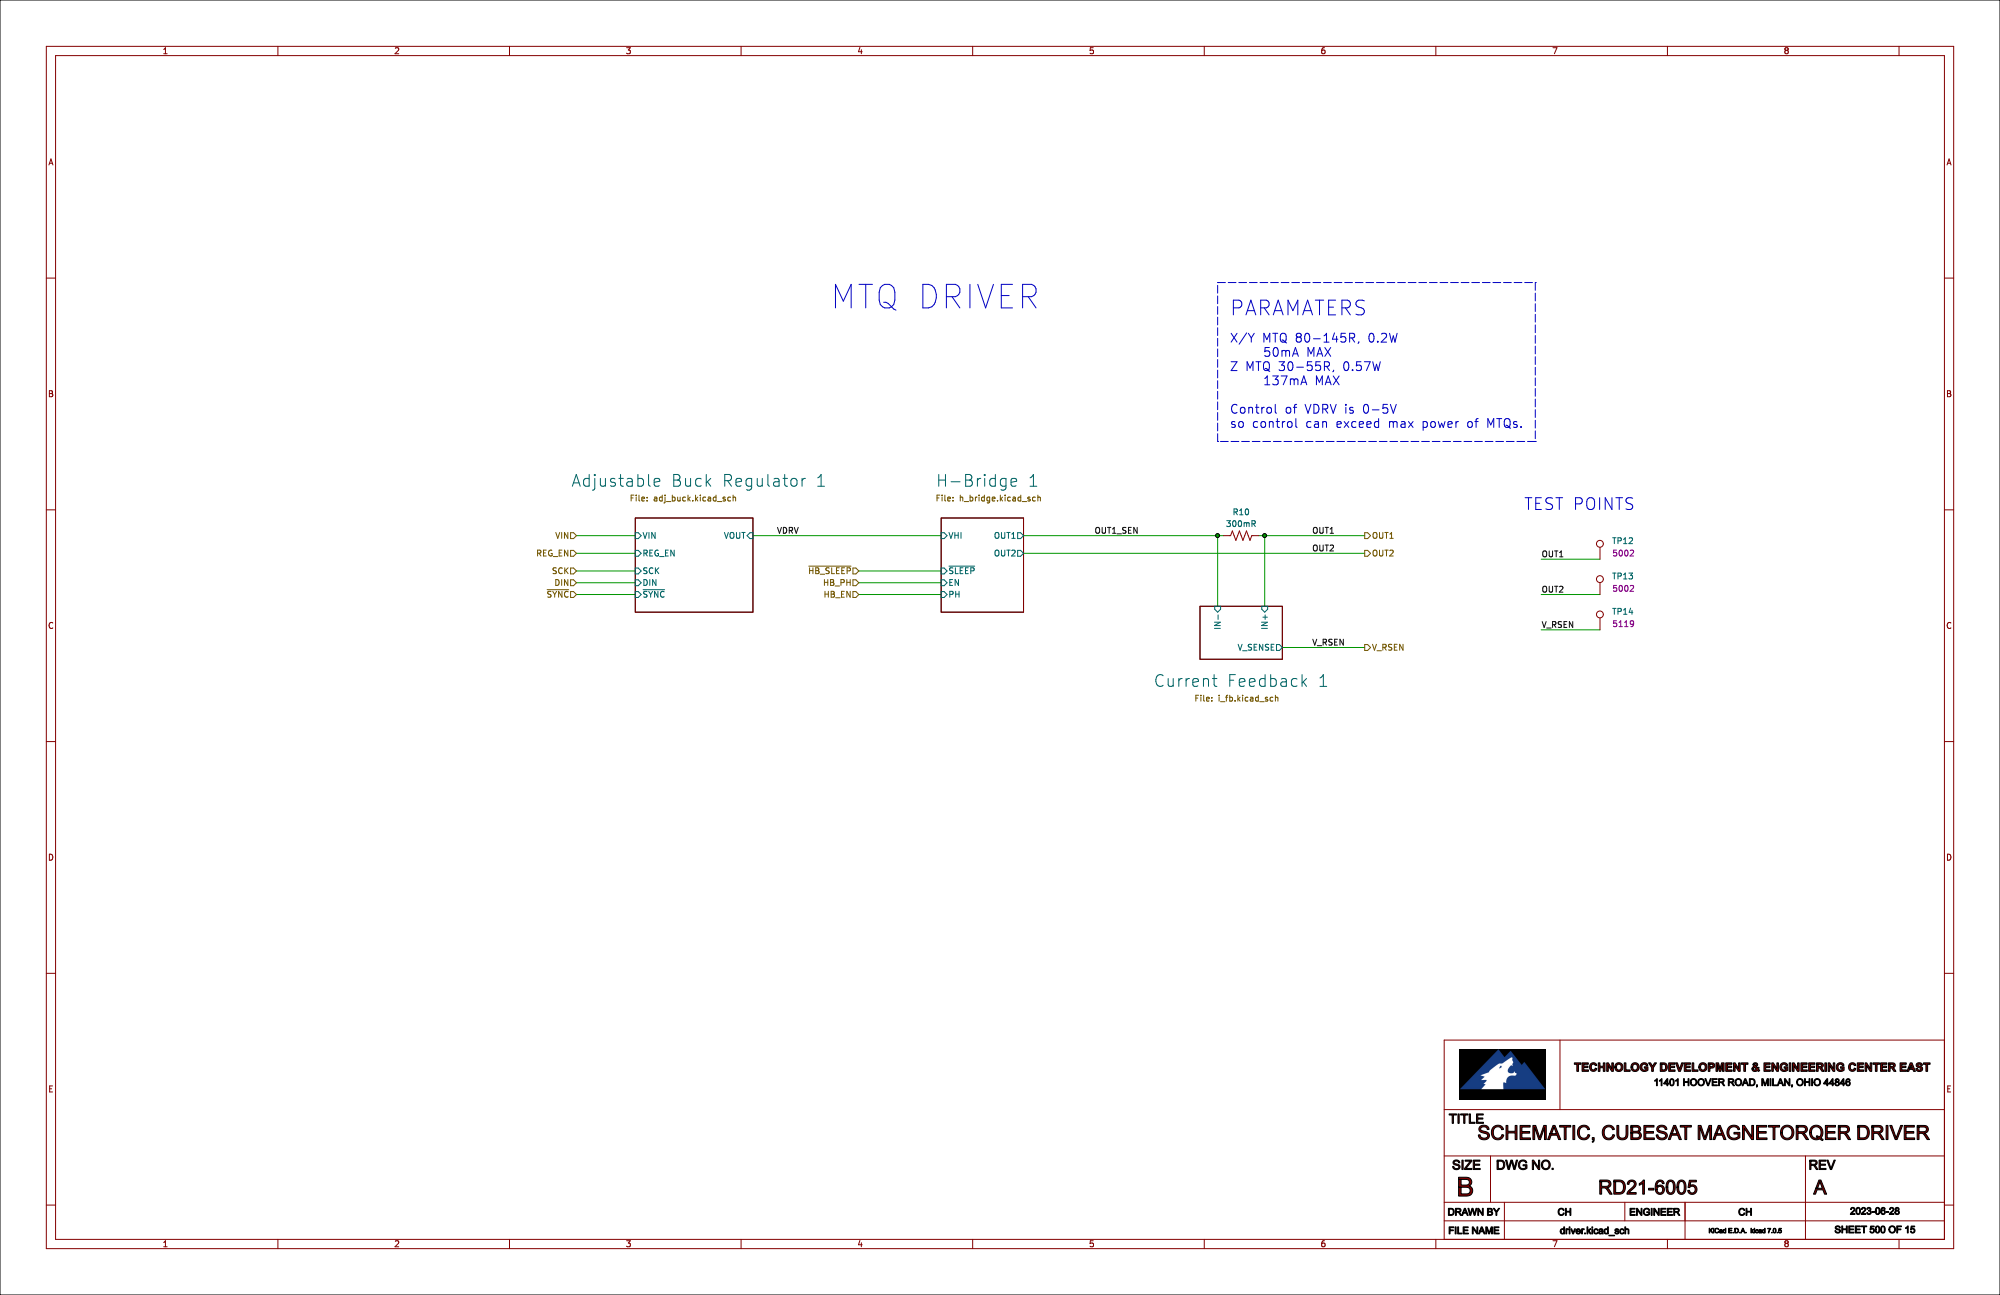
[picture p27: page 7]

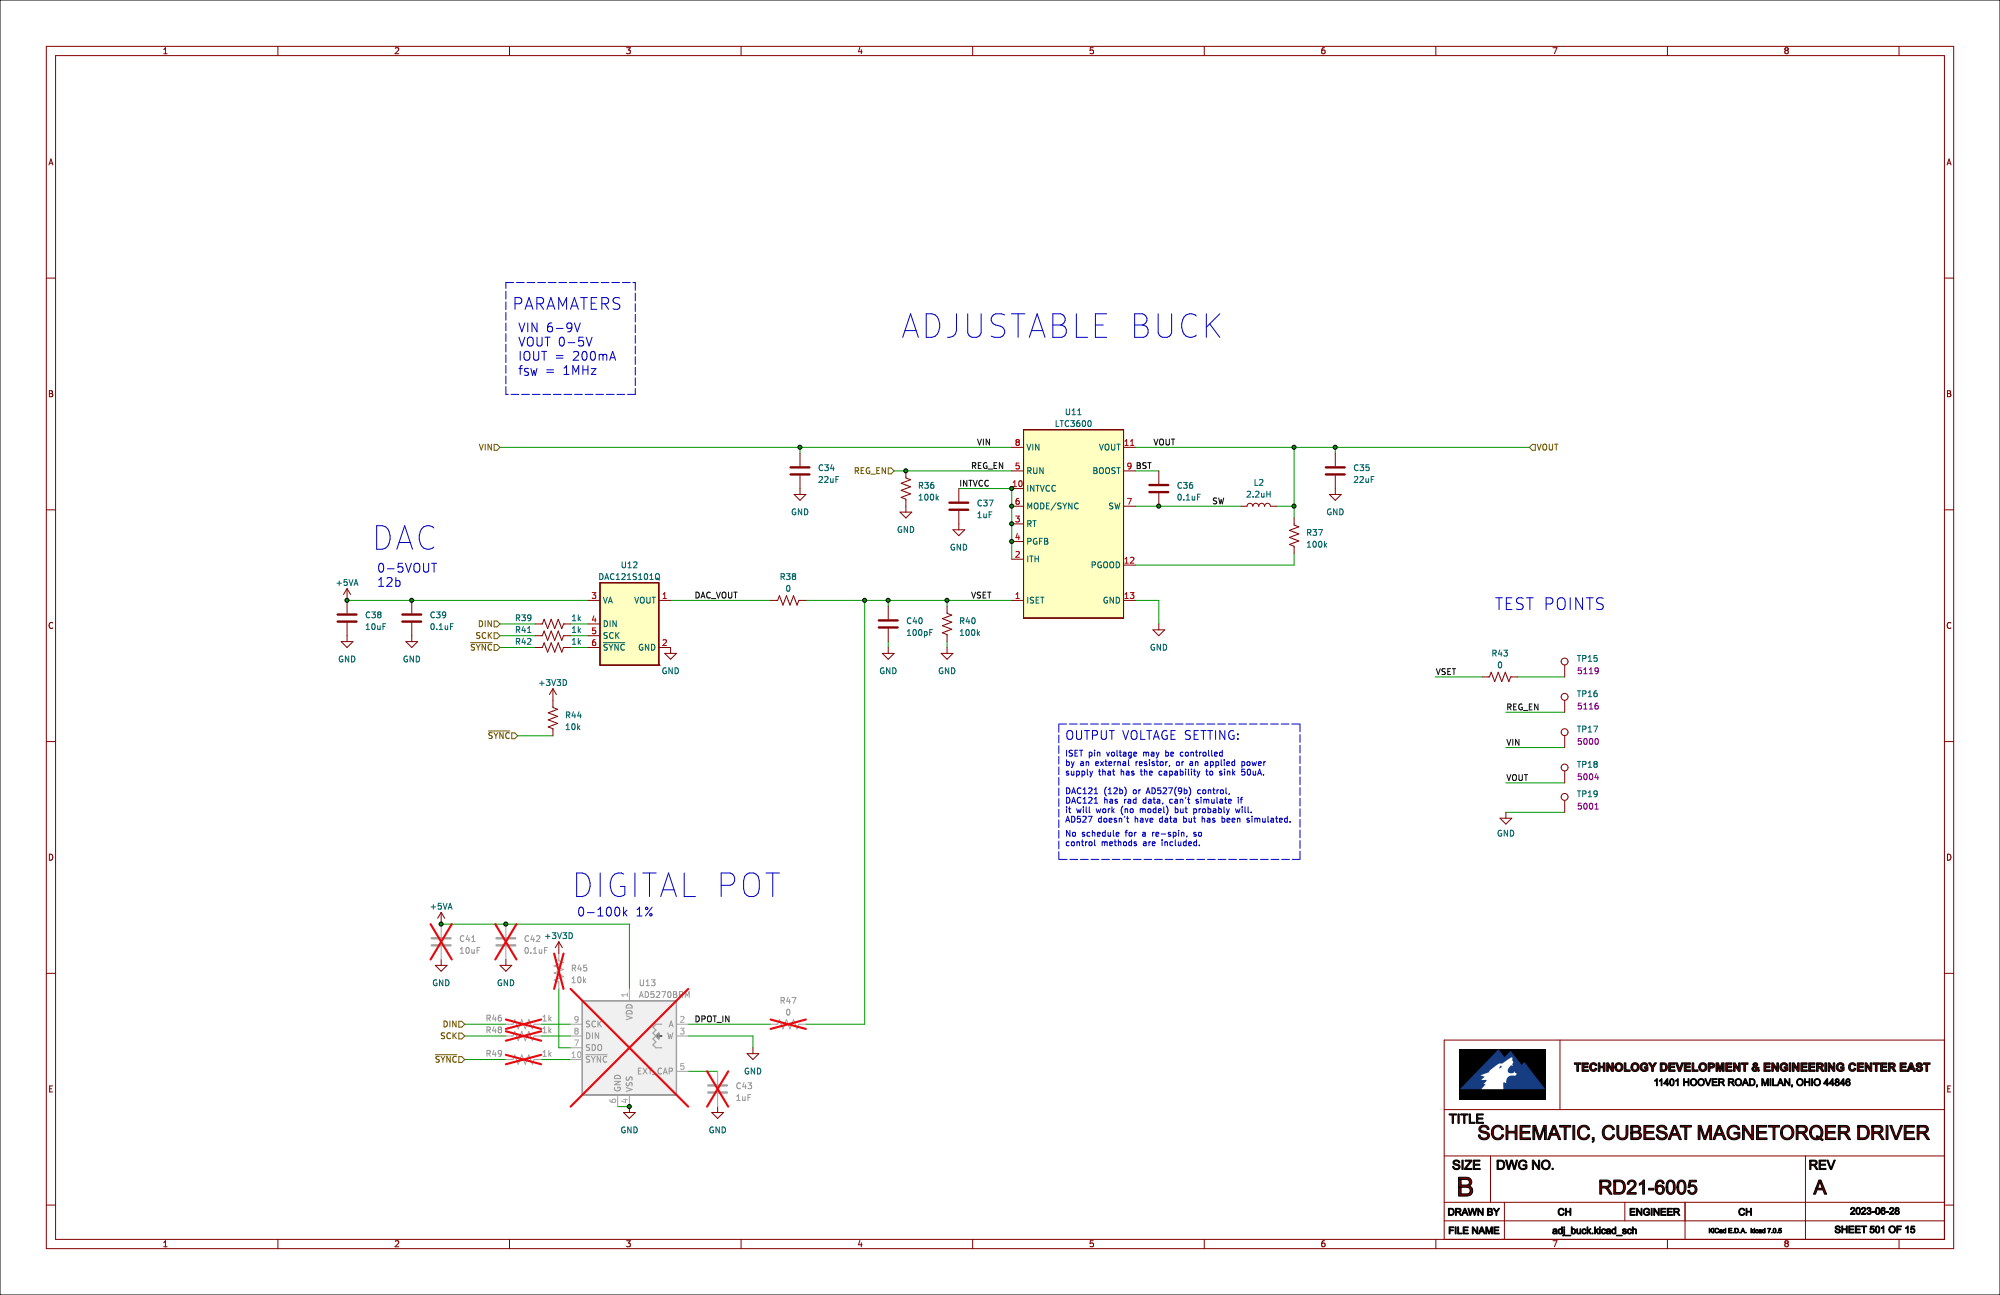
[picture p28: page 8]

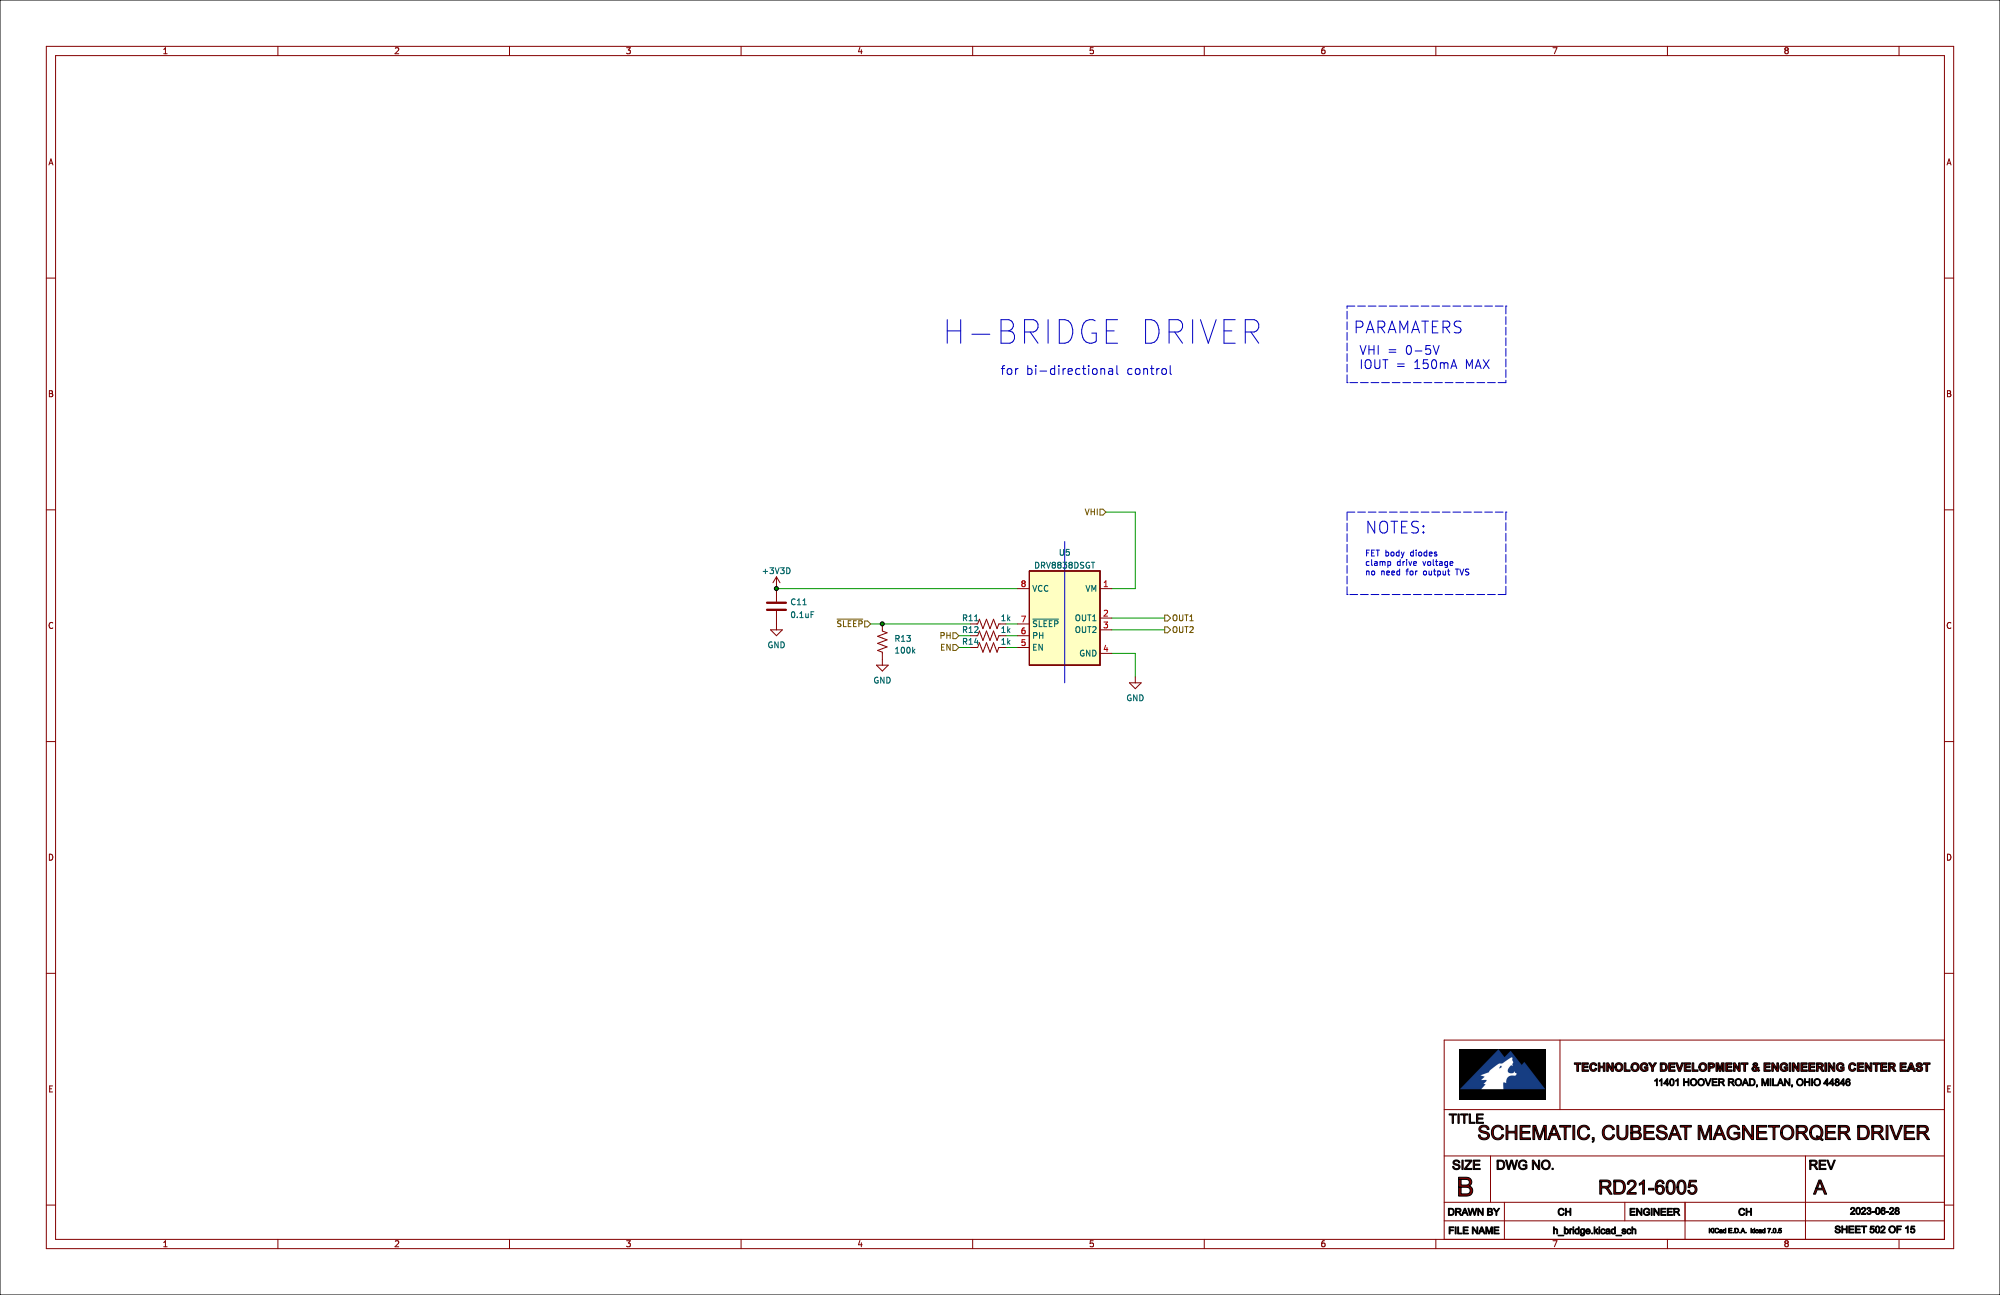
[picture p29: page 9]

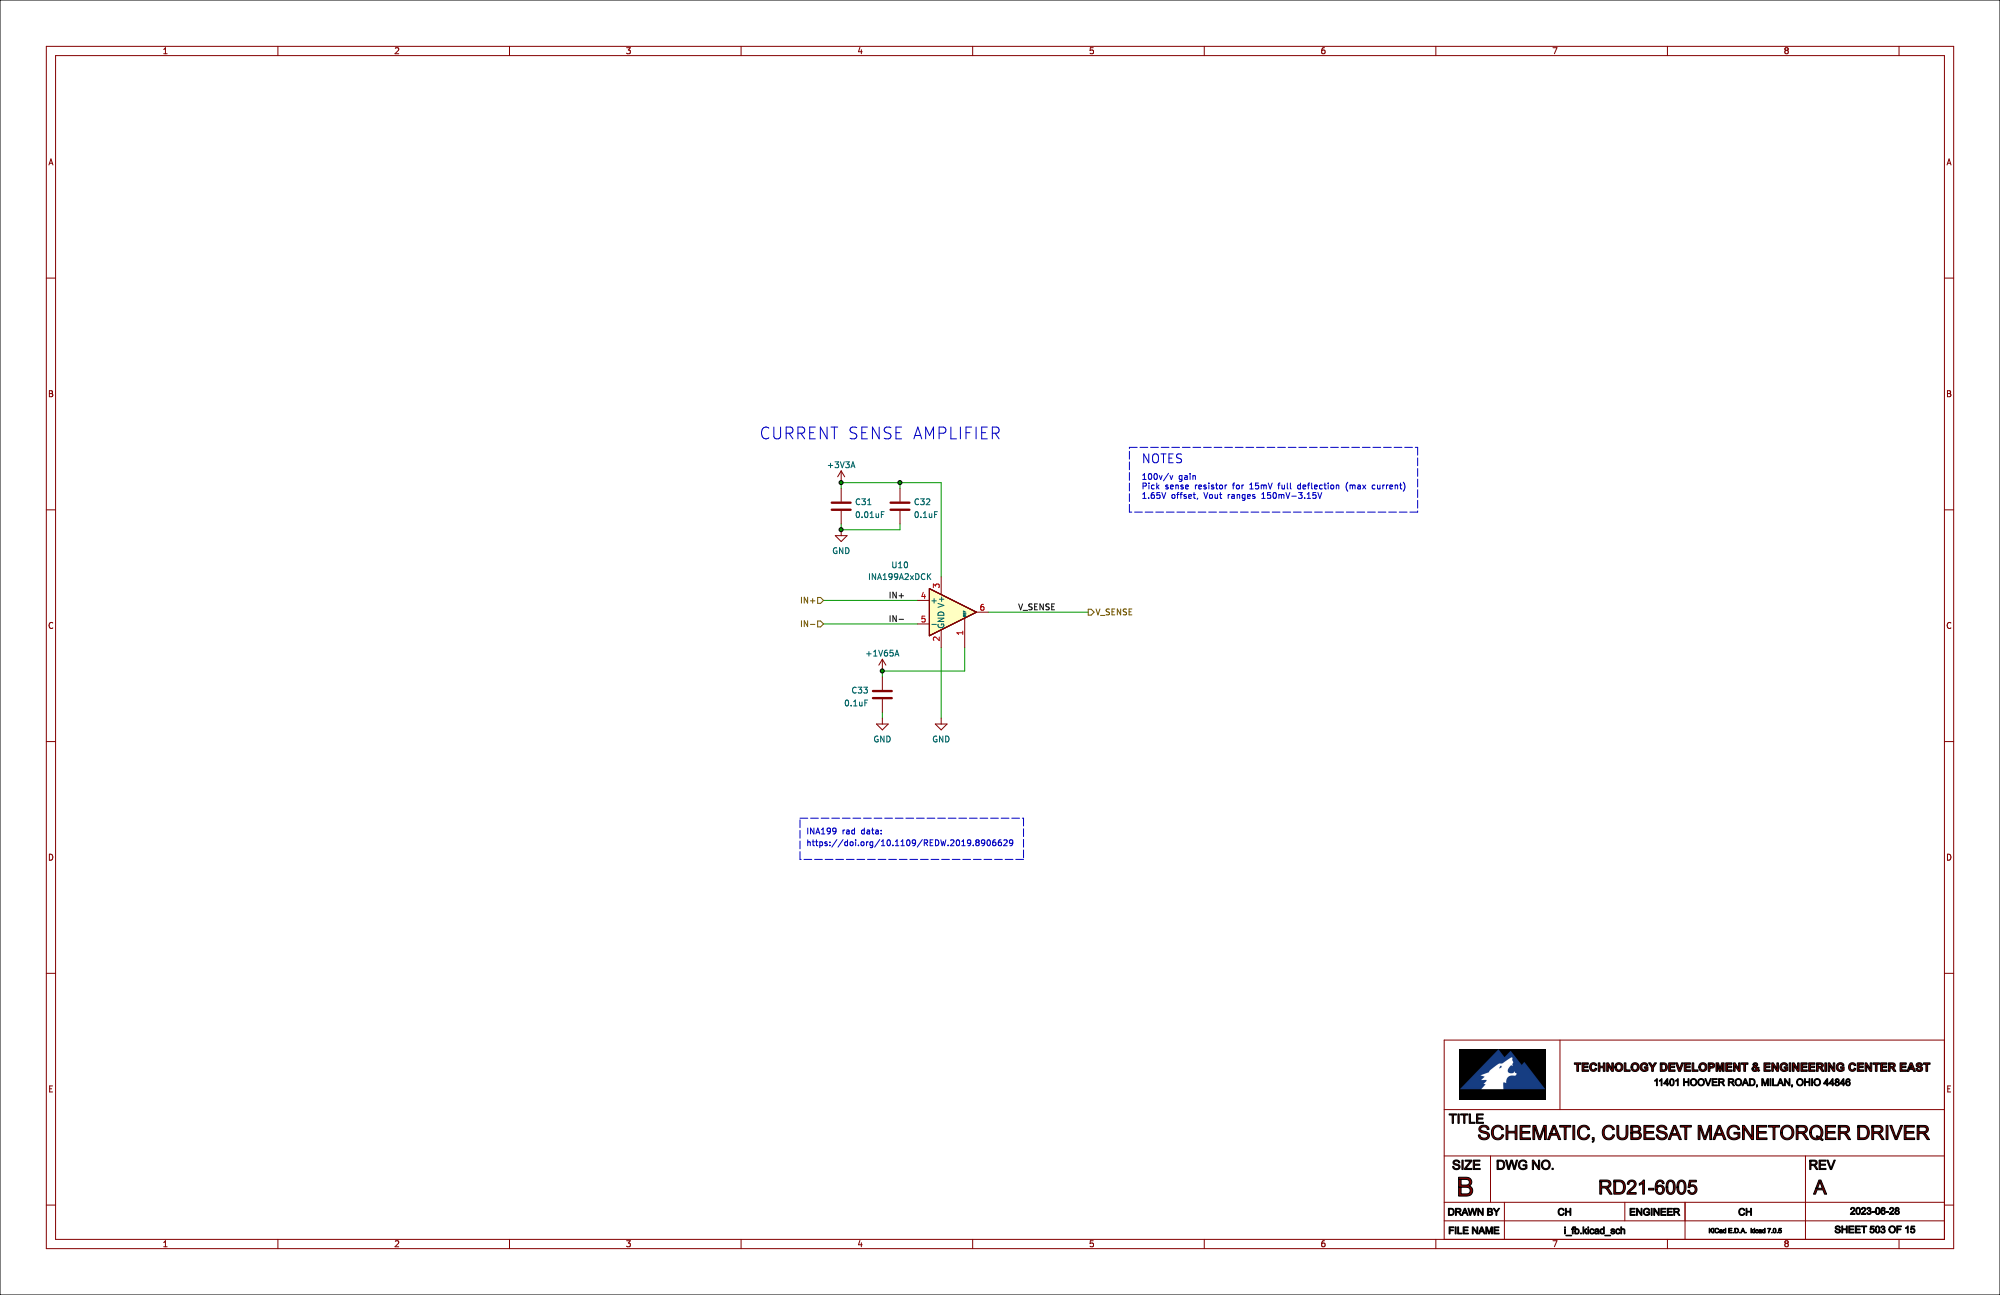
[picture p30: page 10]

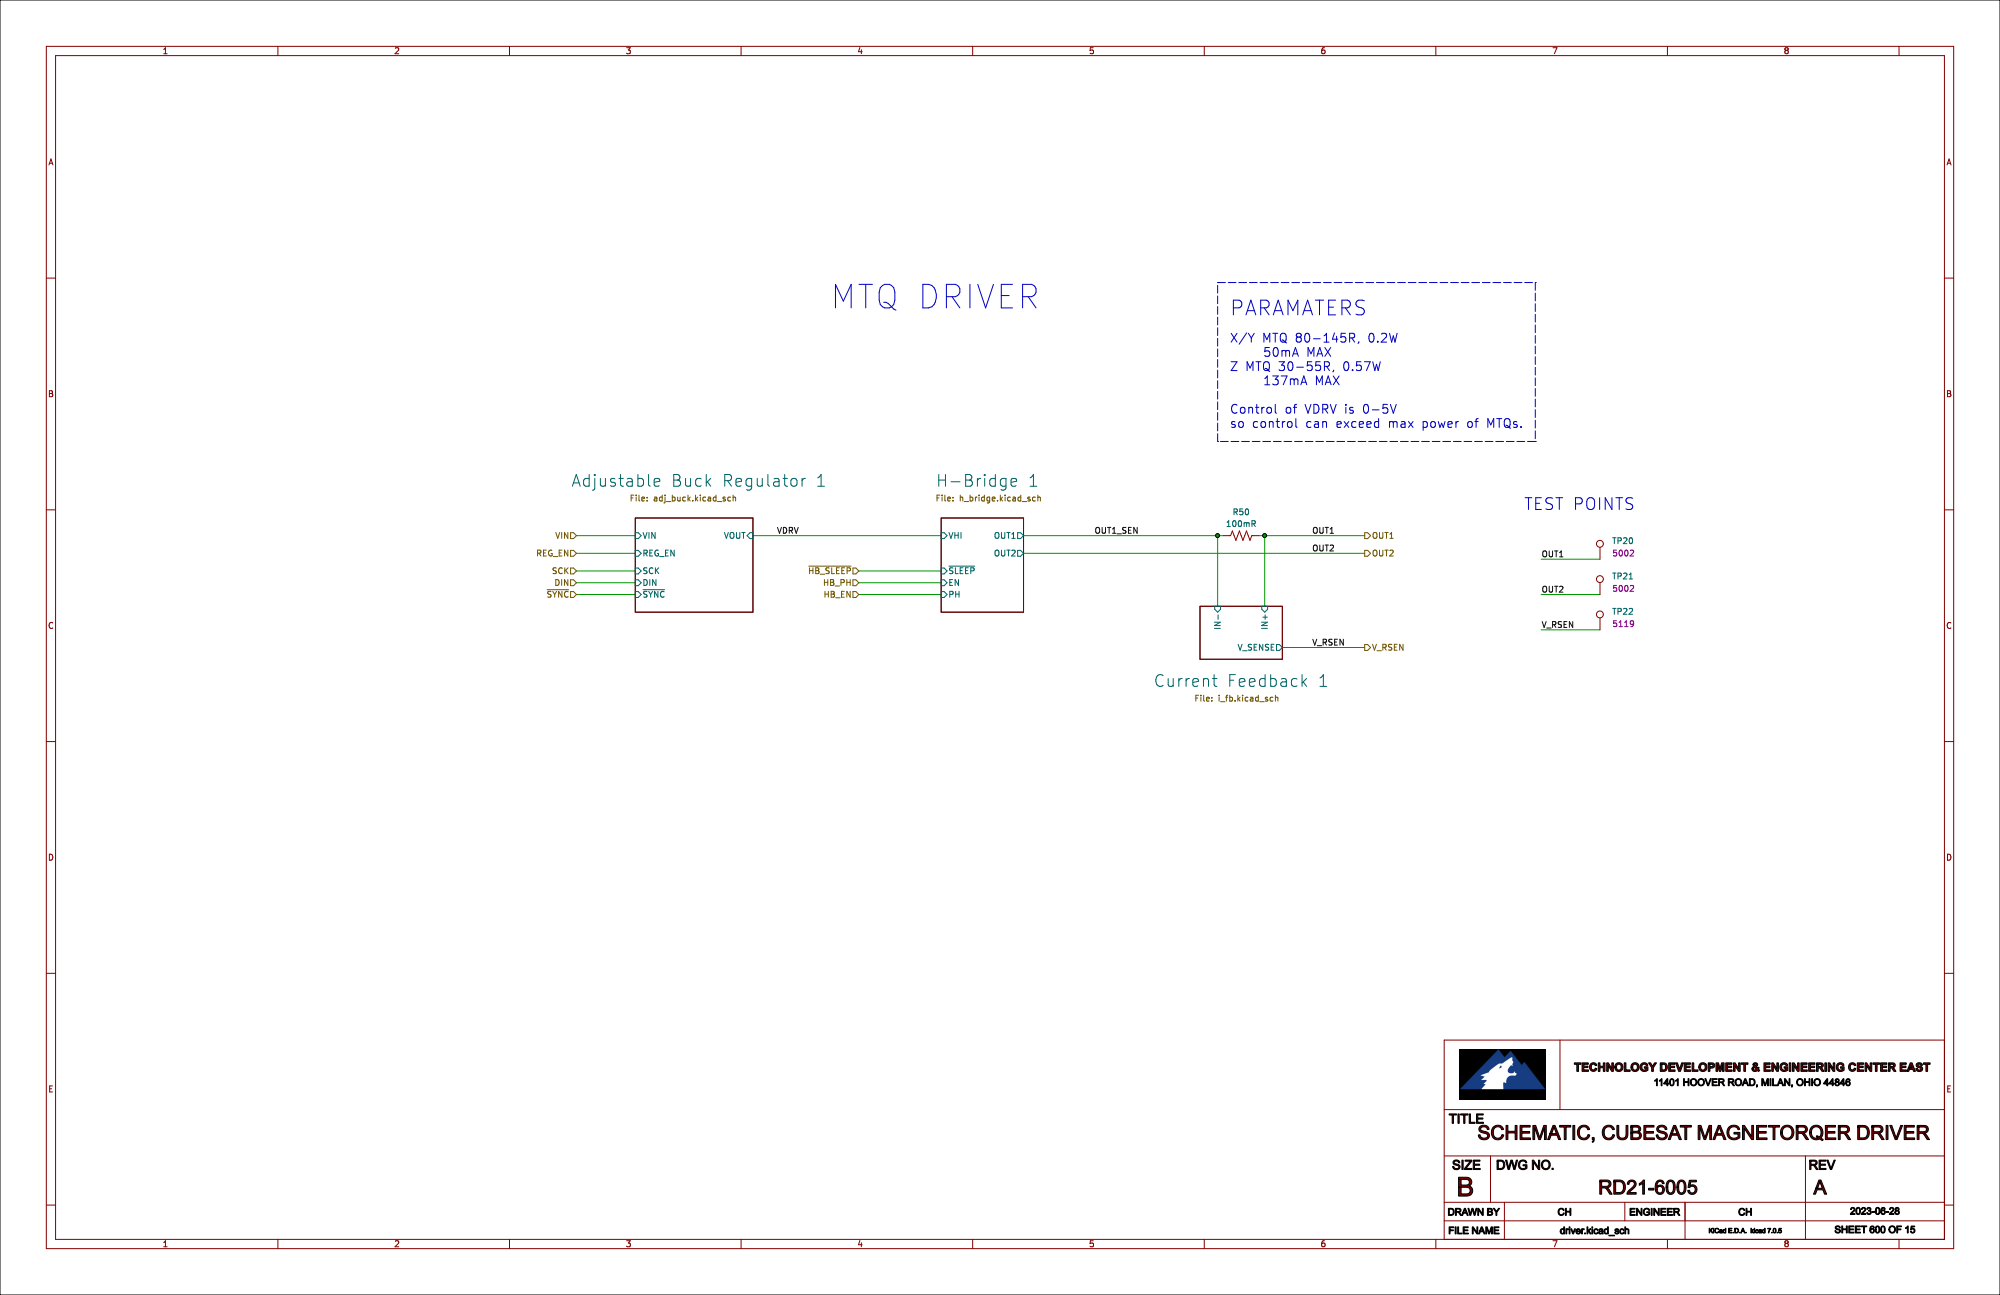
[picture p31: page 11]

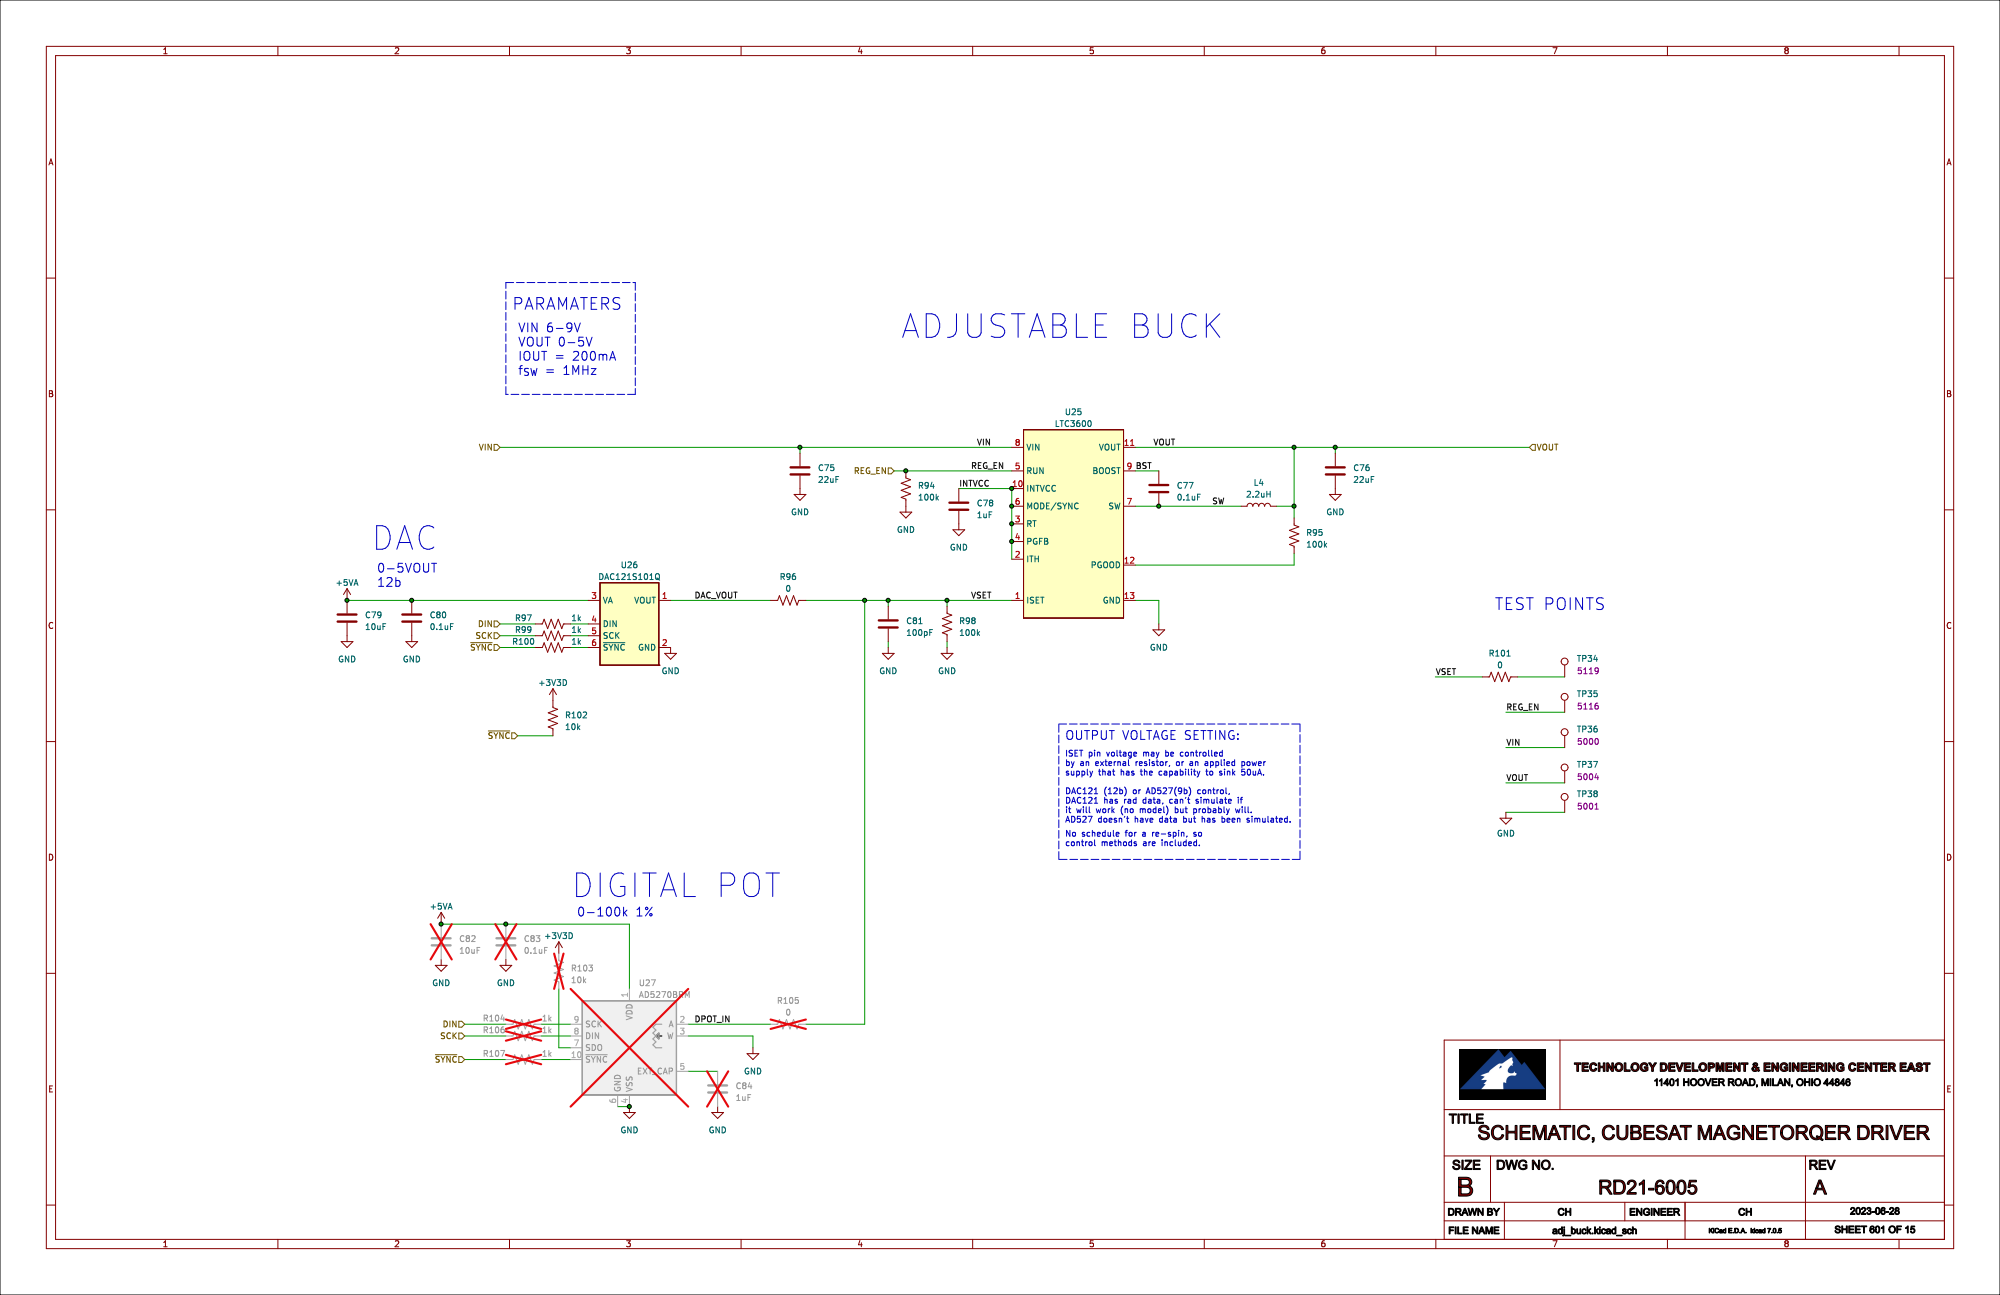
[picture p32: page 12]

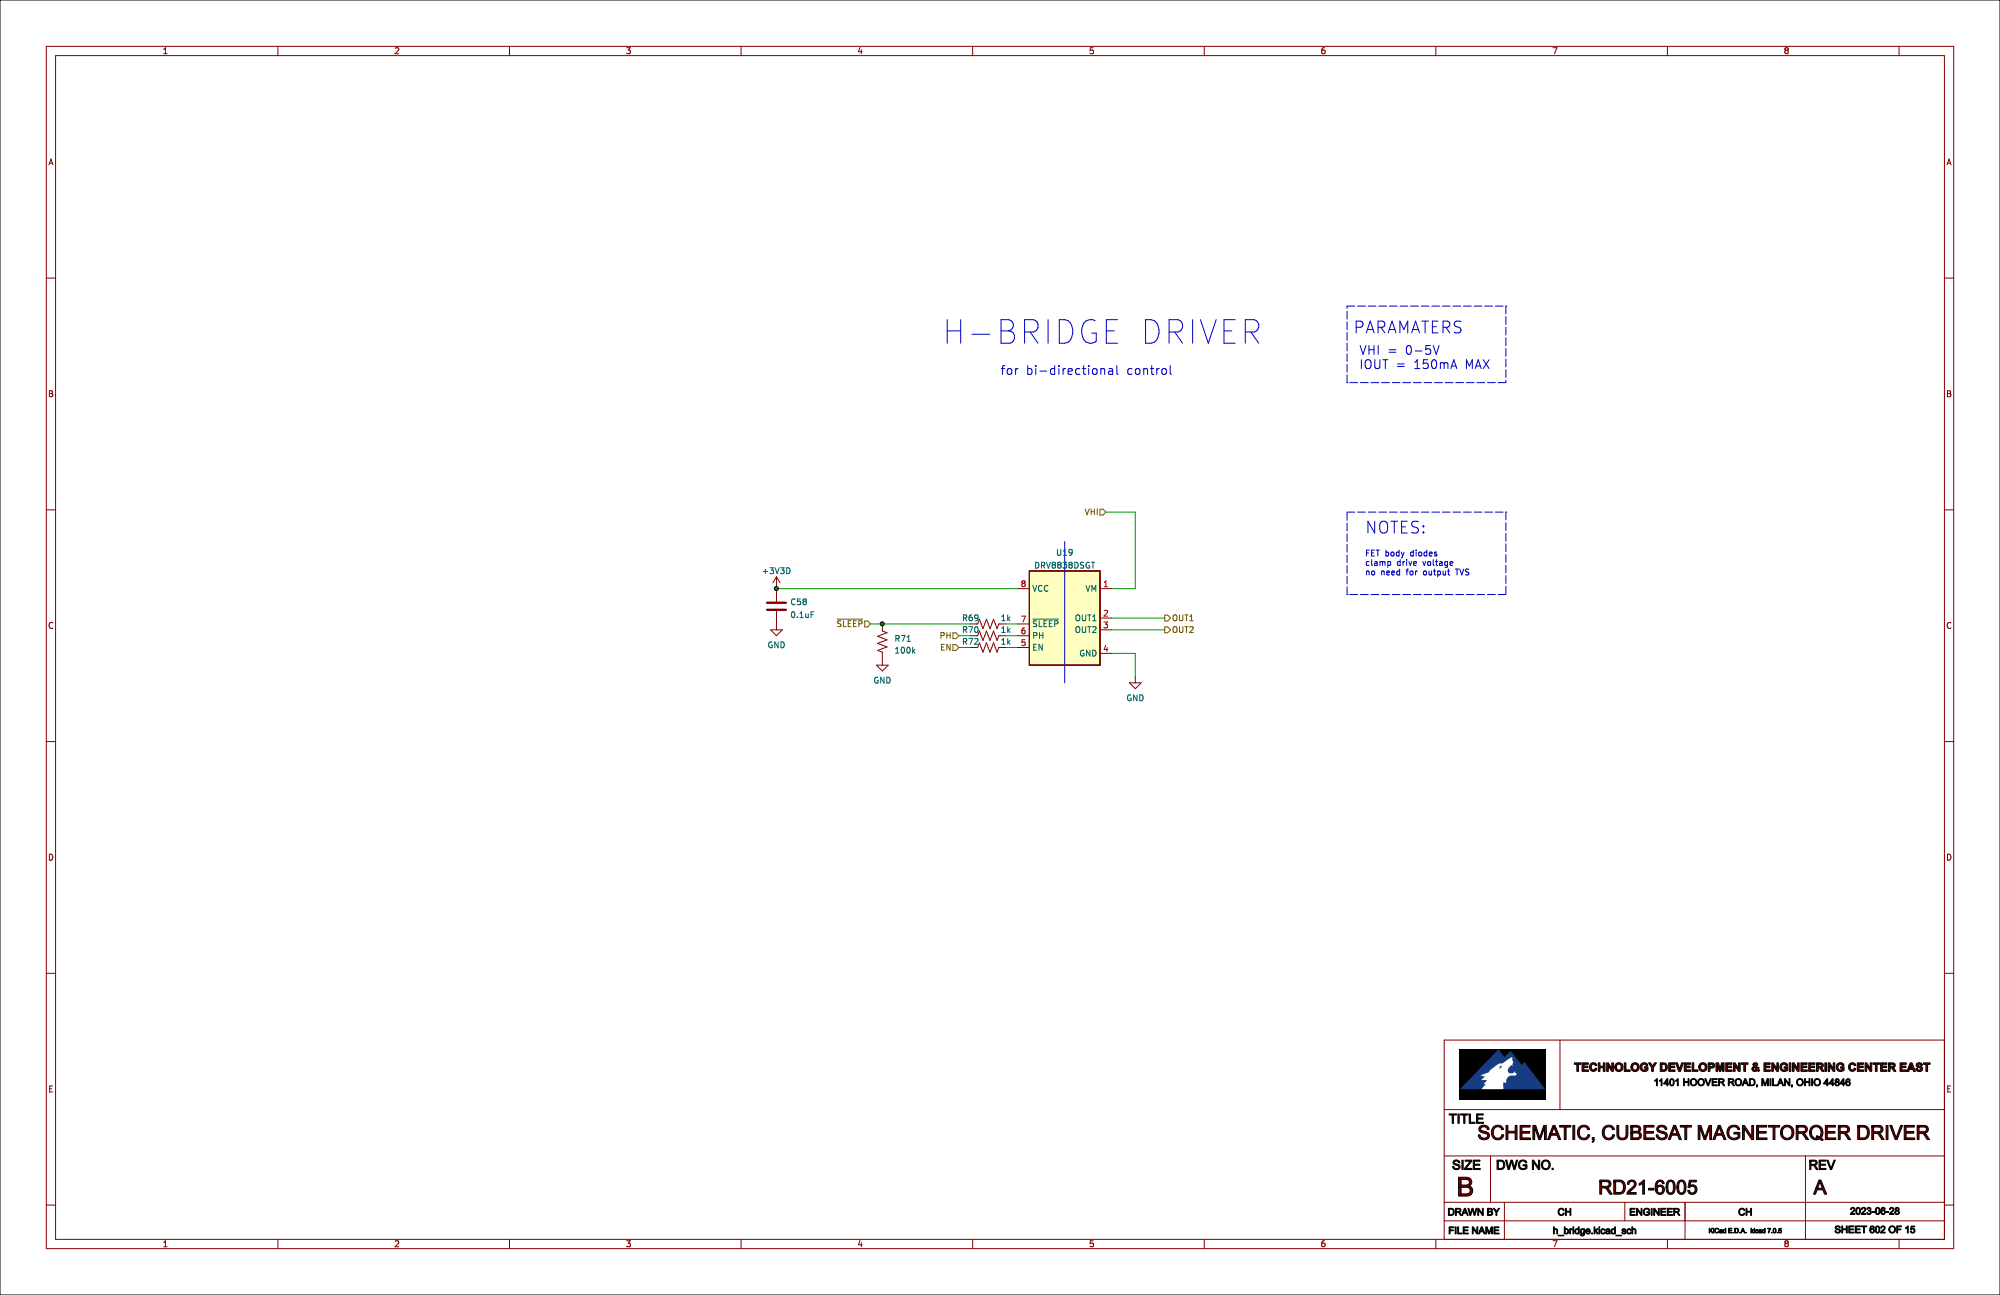
[picture p33: page 13]

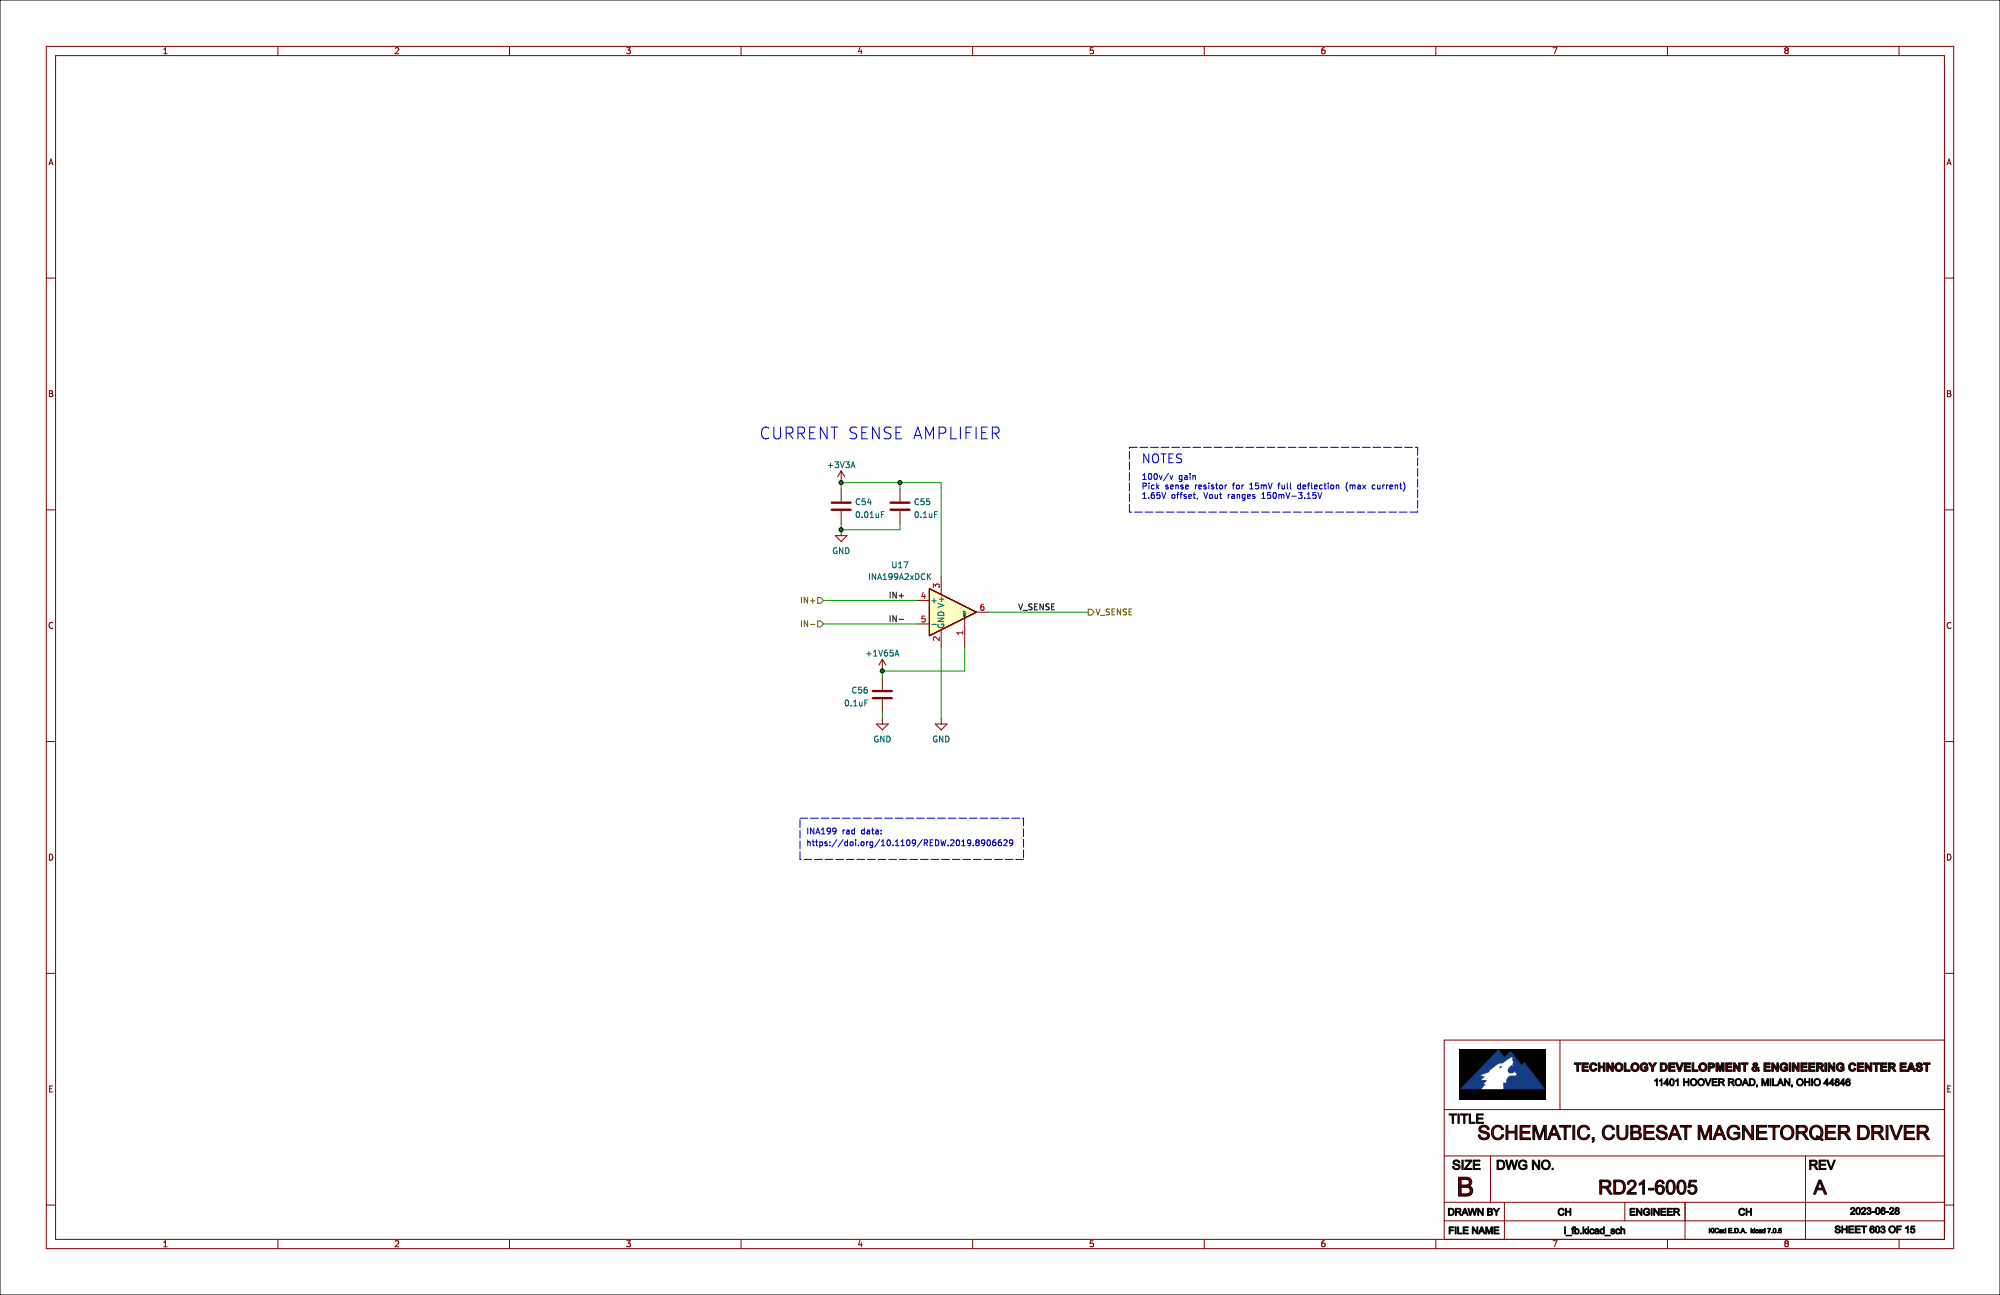
[picture p34: page 14]

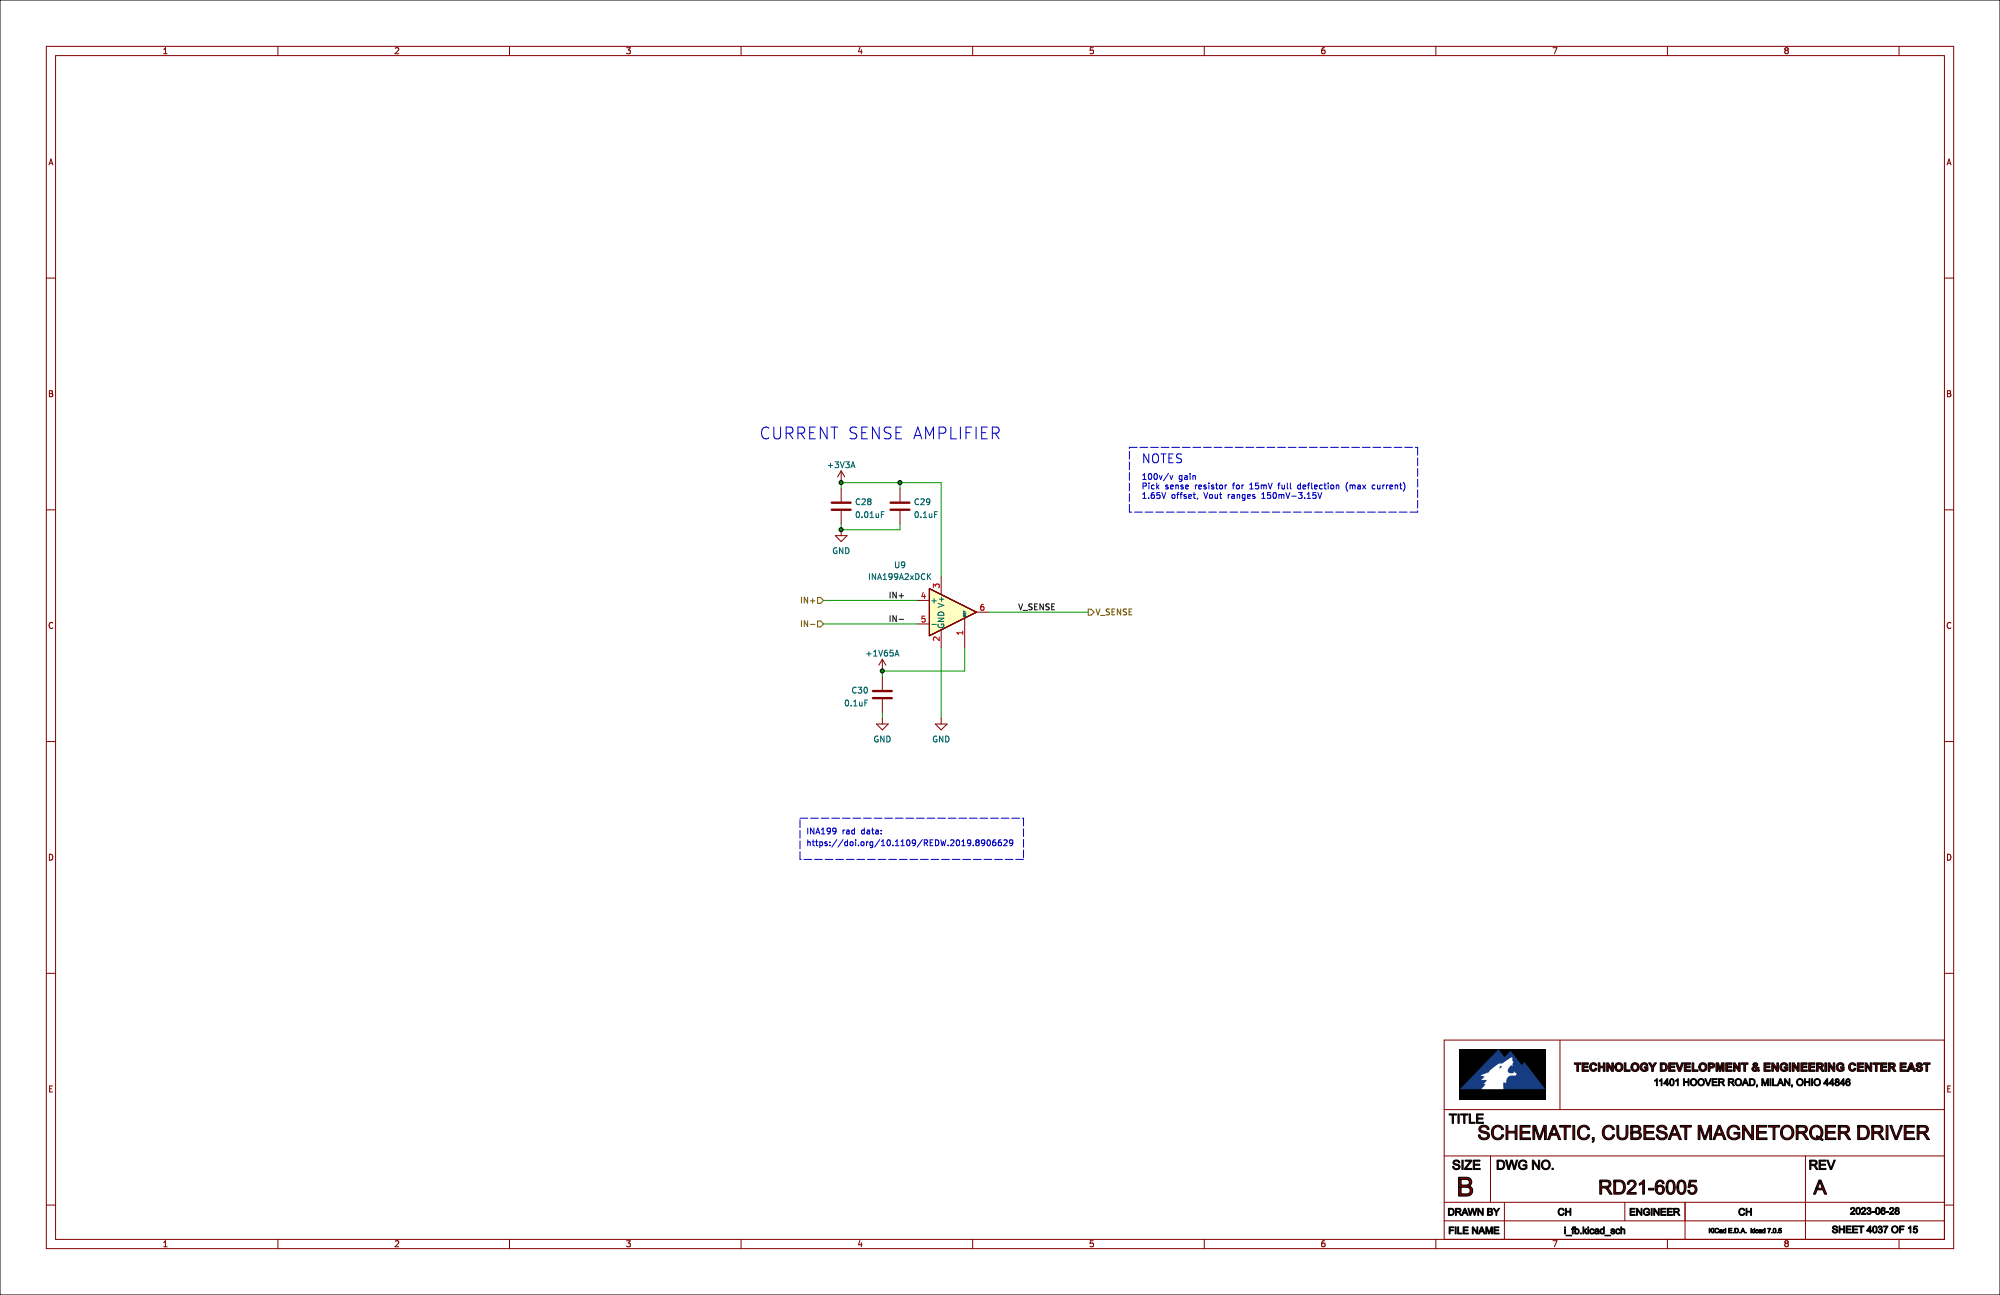
[picture p35: page 15]
