Sierra-Lobo/mtdb-hw/revA/magnetotorqer-drive-board.kicad_pcb

## KiCad design revA/magnetotorqer-drive-board.kicad_pcb (2023-06-28)

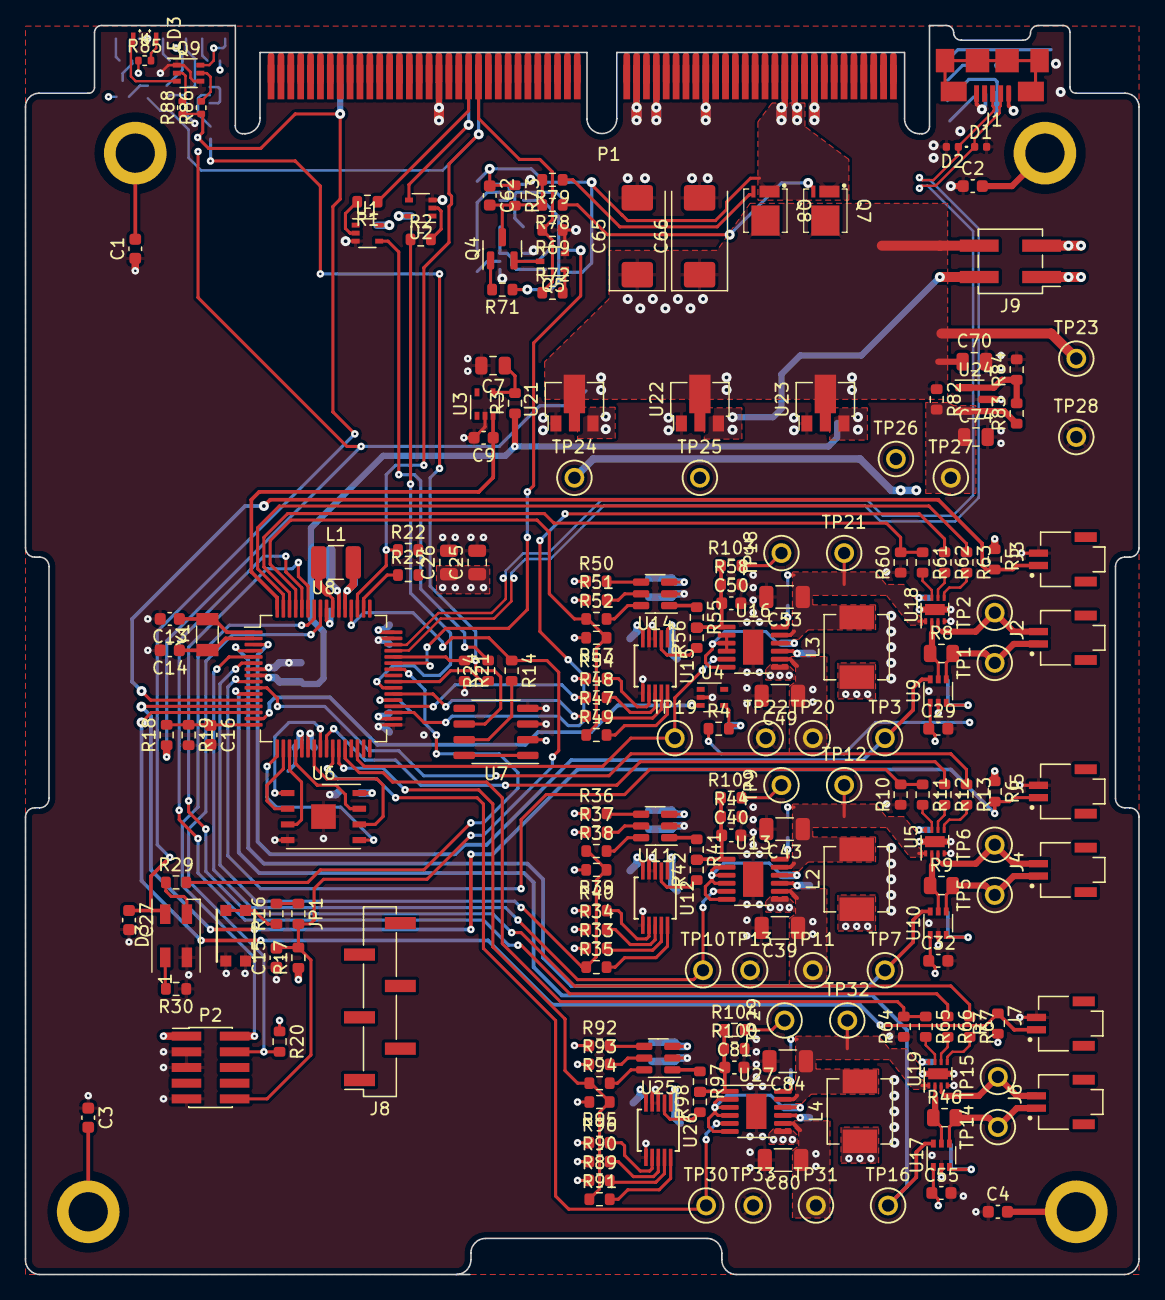
[picture p36: board magnetotorqer-drive-board.kicad_pcb from above]

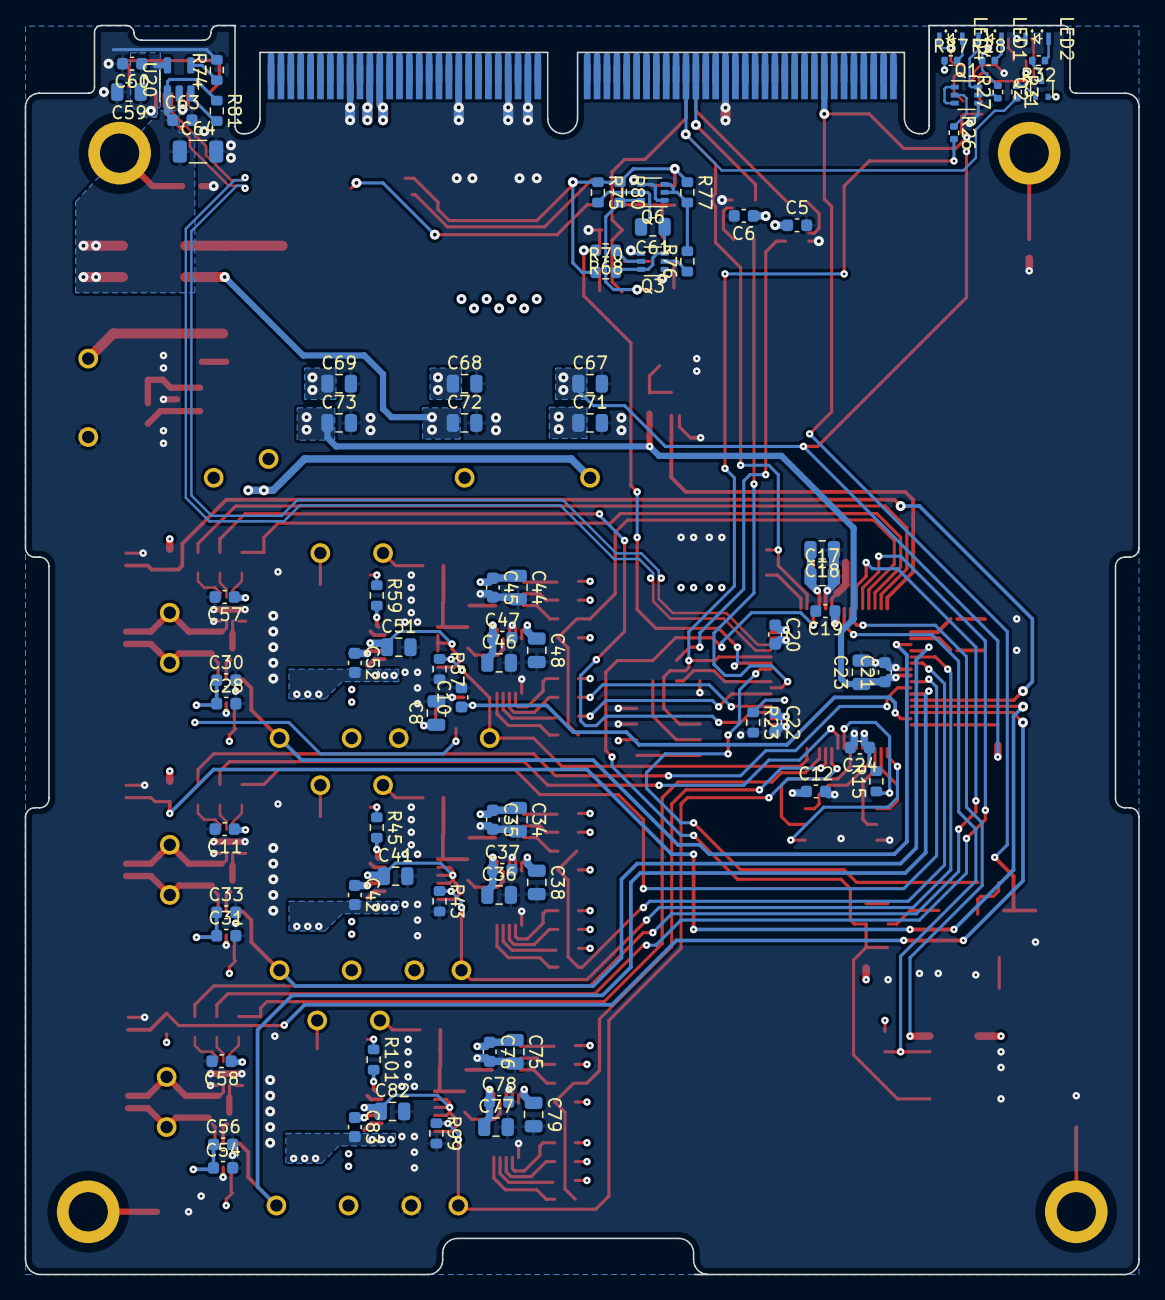
[picture p37: board magnetotorqer-drive-board.kicad_pcb from below]

Board: 4 copper layers, 90.2 x 101.1 mm, 283 parts (84 on the bottom side), 175 nets.

Parts:
C1, C2, C3, C4, C5, C6, C9, C10, C11, C12, C15, C16, C19, C20, C21, C22, C24, C27, C29, C30, C32, C33, C35, C37, C42, C45, C47, C52, C55, C56, C57, C58, C60, C62, C63, C76, C78, C83: 0.1uF; C_0603_1608Metric
C7, C8, C18, C38, C41, C48, C51, C67, C68, C69, C70, C71, C72, C73, C79, C82: 1uF; C_0805_2012Metric
C13, C14: 8pF; C_0603_1608Metric
C17, C23, C25, C26, C34, C36, C44, C46, C59, C61, C74, C75, C77: 10uF; C_0805_2012Metric
C28, C31, C54: 0.01uF; C_0603_1608Metric
C39, C43, C49, C53, C80, C84: 22uF; C_1206_3216Metric
C40, C50, C81: 100pF; C_0603_1608Metric
C64: 47uF; C_1206_3216Metric
C65, C66: 47uF; CP_EIA-7343-43_Kemet-X
D1, D2: ESD321DPYR; D_0402_1005Metric
D3: SK6812MINI; LED_SK6812MINI_PLCC4_3.5x3.5mm_P1.75mm
H1, H2, H3, H4: SLI-Backplane-Blank-Card-KiCad:125mil_hole; 125mil_hole
J1: ZX62-AB-5PA(31)
J2, J3, J4, J5, J6, J7: T1M-02-F-SH-L; SAMTEC_T1M-02-F-SH-L-K
J8: Conn_01x06; PinHeader_1x06_P2.54mm_Vertical_SMD_Pin1Right
J9: Conn_02x02_Top_Bottom; PinHeader_2x02_P2.54mm_Vertical_SMD
JP1: Wire Cut Jumper; R_0603_1608Metric
L1: 10uH; L_1210_3225Metric
L2, L3, L4: 2.2uH; L_Vishay_IHLP-2020
LED1: YELLOW; APA2107x
LED2: RED; APA2107x
LED3: GREEN; APA2107x
LED4: ORANGE; APA2107x
P1: Card Edge for HSEC8-160-01-S-DV-A-K-TR; HSEC8-160-CARD-EDGE
P2: FTSH-105-01-F-DV-K-TR; PinHeader_2x05_P1.27mm_Vertical_SMD
Q1, Q3, Q6, Q9: MMDT2222A; SOT-363_SC-70-6
Q2: MMBT3906T; SOT-523
Q4: IRLML2803; SOT-23
Q5: MMBT4401WT1G; SOT-323_SC-70
Q7, Q8: BSZ180; PG-TSDSON-8_3.3x3.3mm
R1, R2, R11, R12, R13, R24, R25, R33, R34, R35, R36, R37, R38, R47, R48, R49, R50, R51, R52, R61, R62, R63, R65, R66, R67, R71, R78, R79, R89, R90, R91, R92, R93, R94: 1k; R_0603_1608Metric
R3, R4: 220; R_0603_1608Metric
R5, R6, R7, R14, R15, R17, R20, R21, R22, R30, R39, R40, R53, R54, R68, R74, R81, R82, R95, R96: 10k; R_0603_1608Metric
R8, R9, R46: ${R_sense}; R_0805_2012Metric
R10, R23, R43, R44, R45, R57, R58, R59, R60, R64, R69, R70, R72, R73, R77, R99, R100, R101: 100k; R_0603_1608Metric
R16: 330; R_0603_1608Metric
R18: 330k; R_0603_1608Metric
R19: 110k; R_0603_1608Metric
R26, R27, R31, R86, R88: 10k; R_0402_1005Metric
R28, R32, R85, R87: 1.5k; R_0402_1005Metric
R29: 499; R_0603_1608Metric
R41, R42, R55, R56, R97, R98, R102, R103, R104: 0; R_0603_1608Metric
R75: 200k; R_0603_1608Metric
R76: 20k; R_0603_1608Metric
R80: 73.2k; R_0603_1608Metric
R83: 12.4k; R_0603_1608Metric
R84: 4.1k; R_0603_1608Metric
SW1: KMR231NG LFS; KMR2_4.6X2.8
TP1, TP2, TP3, TP5, TP6, TP7, TP9, TP10, TP11, TP12, TP13, TP14, TP15, TP16, TP18, TP19, TP20, TP21, TP22, TP23, TP24, TP25, TP26, TP27, TP28, TP29, TP30, TP31, TP32, TP33: ${NET_NAME(1)}; TestPoint_Keystone_5000-5004_Miniature
U1, U2: 74LVC1G17; SOT-353_SC-70-5
U3, U4: MCP9700AT-E/LT; SOT-353_SC-70-5
U5, U18, U19: DRV8838DSGT; WSON-8-1EP_2x2mm_P0.5mm_EP0.9x1.6mm
U6: MR25H10MDF; DFN-8-1EP_6x5mm_P1.27mm_EP2x2mm
U7: MAX708RESA-T; SO-8_3.9x4.9mm_P1.27mm
U8: ATSAMD51J20A-A; TQFP-64_10x10mm_P0.5mm
U9, U10, U17: INA199A2xDCK; SOT-363_SC-70-6
U11, U14, U25: DAC121S101Q; TSOT-23-6
U12, U15, U26: AD5270BRM; MSOP-10_3x3mm_P0.5mm
U13, U16, U27: LTC3600; MSOP-12-1EP_3x4mm_P0.65mm_EP1.65x2.85mm
U20: AP2161W; SOT-23-5
U21, U23: MCP1700T-33; SOT-89-3
U22: MCP1700T-50; SOT-89-3
U24: ATL431BQ; SOT-23
Y1: 32.768kHz; Crystal_SMD_3215-2Pin_3.2x1.5mm

Connections:
+1V65A: C29.1, C32.1, C55.1, C74.1, R82.2, R83.1, TP27.1, U9.1 (REF), U10.1 (REF), U17.1 (REF), U24.2 (K)
+3V3A: C21.1, C23.1, C28.1, C30.1, C31.1, C33.1, C54.1, C56.1, C73.1, R3.1, R4.1, R5.1, R6.1, R7.1, TP26.1, U8.8 (VDDANA), U9.3 (V+), U10.3 (V+), U17.3 (V+), U23.3 (VO)
+3V3D: C5.1, C6.1, C11.1, C12.1, C19.1, C20.1, C22.1, C24.1, C25.1, C26.1, C57.1, C58.1, C71.1, P2.1, R15.2, R17.1, R20.1, R39.2, R40.1, R53.2, R54.1, R87.1, R95.2, R96.1, TP24.1, U1.5 (VCC), U2.5 (VCC), U5.8 (VCC), U6.8 (VDD), U7.2 (VCC), U8.21 (VDDIOB), U8.34 (VDDIO), U8.48 (VDDIO), U8.56 (VDDIO), U18.8 (VCC), U19.8 (VCC), U21.3 (VO)
+5VA: C34.1, C35.1, C36.1, C37.1, C44.1, C45.1, C46.1, C47.1, C72.1, C75.1, C76.1, C77.1, C78.1, J9.2, TP25.1, U11.3 (VA), U12.1 (VDD), U14.3 (VA), U15.1 (VDD), U22.3 (VO), U25.3 (VA), U26.1 (VDD)
/5V_USB: C59.1, C60.1, J1.1 (VBUS), U20.5 (IN)
/Control/MISO: R23.1, U8.37 (PA18)
/Control/NEOPIXEL_DIN: R29.2, U8.42 (PA21)
/Control/QSPI/CS: R15.1, U6.1 (~CS), U8.24 (PB11)
/Control/QSPI/DATA0: U6.5 (SI), U8.17 (PA08)
/Control/QSPI/DATA1: U6.2 (SO), U8.18 (PA09)
/Control/QSPI/DATA2: U6.3 (~WP), U8.19 (PA10)
/Control/QSPI/DATA3: U6.7 (~HOLD), U8.20 (PA11)
/Control/QSPI/SCK: U6.6 (SCK), U8.23 (PB10)
/Control/SWCLK: P2.4, R20.2, U8.57 (PA30)
/Control/SWDIO: P2.2, U8.58 (PA31)
/Control/VAA_ADC: C16.1, R18.2, R19.1, U8.16 (PA07)
/Control/VDDCORE: C17.1, C18.2, L1.2, U8.53 (VDDCORE)
/Control/VSW: L1.1, U8.55 (VSW)
/Control/WDT_WDI: R21.1, R26.2, U7.6 (~WDI), U8.44 (PA23)
/Control/XTAL1: C13.1, U8.1 (PA00), Y1.1
/Control/XTAL2: C14.1, U8.2 (PA01), Y1.2
/D+: D2.1 (K), J1.3 (D+), U8.45 (PA24)
/D-: D1.1 (K), J1.2 (D-), U8.46 (PA25)
/HARD_RESET: R68.2, U8.43 (PA22)
/MOSI: R33.1, R36.1, R47.1, R50.1, R89.1, R92.1, U8.38 (PA19)
/PWR_EN: P1.44, R69.2, R72.1
/Power/~HRST: Q6.6 (C2), R71.1, R80.2
/RX: R24.2, U1.4
/RX_4: P1.41, U2.4
/SCK: R34.1, R37.1, R48.1, R51.1, R90.1, R93.1, U8.36 (PA17)
/TEMP_A: C9.1, U3.3 (V_{OUT}), U8.64 (PB03)
/TEMP_B: C10.1, U4.3 (V_{OUT}), U8.15 (PA06)
/TX: R2.1, U8.39 (PB16)
/TX_4: P1.42, R1.1
/VBATT: C62.1, P1.97, P1.98, P1.99, P1.100, Q7.1 (S), Q8.1 (S), R70.1, R73.1, R75.1, R77.1, R80.1
/X Driver/Adjustable Buck Regulator 1/BST: C52.1, U16.9 (BOOST)
/X Driver/Adjustable Buck Regulator 1/DAC_VOUT: R55.1, U14.1 (VOUT)
/X Driver/Adjustable Buck Regulator 1/DPOT_IN: R56.1, U15.2 (A)
/X Driver/Adjustable Buck Regulator 1/INTVCC: C51.1, U16.2 (ITH), U16.3 (RT), U16.4 (PGFB), U16.6 (MODE/SYNC), U16.10 (INTVCC)
/X Driver/Adjustable Buck Regulator 1/SW: C52.2, L3.1, U16.7 (SW)
/X Driver/Adjustable Buck Regulator 1/VSET: C50.1, R55.2, R56.2, R58.1, R103.1, U16.1 (ISET)
/X Driver/OUT1_SEN: R8.1, U9.5 (-), U18.2 (OUT1)
/X Driver/VDRV: C53.1, L3.2, R59.1, TP21.1, U16.11 (VOUT), U18.1 (VM)
/X+: J2.1, R8.2, TP1.1, U9.4 (+)
/X-: J2.2, TP2.1, U18.3 (OUT2)
/X_HB_PH: R63.1, U8.63 (PB02)
/X_PH_EN: R62.1, U8.35 (PA16)
/X_REG_EN: R57.1, TP19.1, U8.30 (PA13), U16.5 (RUN)
/X_TEMP: J3.1, R5.2, U8.12 (PB09)
/X_VRSEN: TP3.1, U8.3 (PA02), U9.6
/Y Driver/Adjustable Buck Regulator 1/BST: C42.1, U13.9 (BOOST)
/Y Driver/Adjustable Buck Regulator 1/DAC_VOUT: R41.1, U11.1 (VOUT)
/Y Driver/Adjustable Buck Regulator 1/DPOT_IN: R42.1, U12.2 (A)
/Y Driver/Adjustable Buck Regulator 1/INTVCC: C41.1, U13.2 (ITH), U13.3 (RT), U13.4 (PGFB), U13.6 (MODE/SYNC), U13.10 (INTVCC)
/Y Driver/Adjustable Buck Regulator 1/SW: C42.2, L2.1, U13.7 (SW)
/Y Driver/Adjustable Buck Regulator 1/VSET: C40.1, R41.2, R42.2, R44.1, R102.1, U13.1 (ISET)
/Y Driver/OUT1_SEN: R9.1, U5.2 (OUT1), U10.5 (-)
/Y Driver/VDRV: C43.1, L2.2, R45.1, TP12.1, U5.1 (VM), U13.11 (VOUT)
/Y+: J4.1, R9.2, TP5.1, U10.4 (+)
/Y-: J4.2, TP6.1, U5.3 (OUT2)
/Y_HB_PH: R13.1, U8.10 (PB07)
/Y_PH_EN: R12.1, U8.25 (PB12)
/Y_REG_EN: R43.1, TP10.1, U8.5 (PB04), U13.5 (RUN)
/Y_TEMP: J5.1, R6.2, U8.13 (PA04)
/Y_VRSEN: TP7.1, U8.4 (PA03), U10.6
/Z Driver/Adjustable Buck Regulator 1/BST: C83.1, U27.9 (BOOST)
/Z Driver/Adjustable Buck Regulator 1/DAC_VOUT: R97.1, U25.1 (VOUT)
/Z Driver/Adjustable Buck Regulator 1/DPOT_IN: R98.1, U26.2 (A)
/Z Driver/Adjustable Buck Regulator 1/INTVCC: C82.1, U27.2 (ITH), U27.3 (RT), U27.4 (PGFB), U27.6 (MODE/SYNC), U27.10 (INTVCC)
/Z Driver/Adjustable Buck Regulator 1/SW: C83.2, L4.1, U27.7 (SW)
/Z Driver/Adjustable Buck Regulator 1/VSET: C81.1, R97.2, R98.2, R100.1, R104.1, U27.1 (ISET)
/Z Driver/OUT1_SEN: R46.1, U17.5 (-), U19.2 (OUT1)
/Z Driver/VDRV: C84.1, L4.2, R101.1, TP32.1, U19.1 (VM), U27.11 (VOUT)
/Z+: J6.1, R46.2, TP14.1, U17.4 (+)
/Z-: J6.2, TP15.1, U19.3 (OUT2)
/Z_HB_PH: R67.1, U8.59 (PB30)
/Z_PH_EN: R66.1, U8.60 (PB31)
/Z_REG_EN: R99.1, TP30.1, U8.26 (PB13), U27.5 (RUN)
/Z_TEMP: J7.1, R7.2, U8.14 (PA05)
/Z_VRSEN: TP16.1, U8.11 (PB08), U17.6
/~FAULT: P1.43, R22.1, R31.2, U8.51 (PA27)
/~RST: C15.2, JP1.2 (B), P2.10, R14.1, R17.2, U8.52 (~RESET)
/~X_HB_SLEEP: R60.2, R61.1, U8.62 (PB01)
/~X_SYNC: R49.1, R52.1, R53.1, U8.61 (PB00)
/~Y_HB_SLEEP: R10.2, R11.1, U8.9 (PB06)
/~Y_SYNC: R35.1, R38.1, R39.1, U8.6 (PB05)
/~Z_HB_SLEEP: R64.2, R65.1, U8.28 (PB15)
/~Z_SYNC: R91.1, R94.1, R95.1, U8.27 (PB14)
GND: C1.1, C2.1, C3.1, C4.1, C5.2, C6.2, C7.2, C8.2, C9.2, C10.2, C11.2, C12.2, C13.2, C14.2, C15.1, C16.2, C17.2, C18.1, C19.2, C20.2, C21.2, C22.2, C23.2, C24.2, C25.2, C26.2, C27.2, C28.2, C29.2, C30.2, C31.2, C32.2, C33.2, C34.2, C35.2, C36.2, C37.2, C38.2, C39.2, C40.2, C41.2, C43.2, C44.2, C45.2, C46.2, C47.2, C48.2, C49.2, C50.2, C51.2, C53.2, C54.2, C55.2, C56.2, C57.2, C58.2, C59.2, C60.2, C63.2, C64.2, C65.2, C66.2, C67.2, C68.2, C69.2, C70.2, C71.2, C72.2, C73.2, C74.2, C75.2, C76.2, C77.2, C78.2, C79.2, C80.2, C81.2, C82.2, C84.2, D1.2 (A), D2.2 (A), D3.2 (VSS), J1.5 (GND), J3.2, J5.2, J7.2, LED2.1 (K), P1.35, P1.36, P1.67, P1.68, P1.71, P1.72, P1.81, P1.82, P1.103, P1.104, P2.3, P2.5, P2.9, Q1.4 (E1), Q3.1 (E2), Q3.4 (E1), Q5.2 (E), Q6.1 (E2), Q6.4 (E1), Q9.1 (E2), Q9.4 (E1), R10.1, R19.2, R21.2, R22.2, R23.2, R30.1, R43.2, R44.2, R57.2, R58.2, R60.1, R64.1, R69.1, R74.2, R84.2, R99.2, R100.2, SW1.2 (B), TP13.1, TP22.1, TP28.1, TP33.1, U1.3 (GND), U2.3 (GND), U3.2 (GND), U4.2 (GND), U5.4 (GND), U5.9 (GND), U6.4 (VSS), U6.9 (EP), U7.3 (GND), U7.4 (PFI), U8.7 (GNDANA), U8.22 (GND), U8.33 (GND), U8.47 (GND), U8.54 (GND), U9.2 (GND), U10.2 (GND), U11.2 (GND), U12.3 (W), U12.4 (VSS), U12.6 (GND), U13.13 (GND), U14.2 (GND), U15.3 (W), U15.4 (VSS), U15.6 (GND), U16.13 (GND), U17.2 (GND), U18.4 (GND), U18.9 (GND), U19.4 (GND), U19.9 (GND), U20.2 (GND), U21.1 (GND), U22.1 (GND), U23.1 (GND), U24.3 (A), U25.2 (GND), U26.3 (W), U26.4 (VSS), U26.6 (GND), U27.13 (GND)
LED_VCC: C27.1, D3.4 (VDD), P1.15, Q2.2 (E), R27.2, R28.1, R86.1, R88.1
unnamed: C1.2, H1.1
unnamed: C2.2, H2.1
unnamed: C3.2, H3.1
unnamed: C4.2, H4.1
unnamed: D3.3 (DIN), R29.1
unnamed: D3.1 (DOUT), R30.2
unnamed: C63.1, C64.1, J9.1, J9.3, R81.1, U20.1 (OUT)
unnamed: JP1.1 (A), R16.2
unnamed: LED1.2 (A), R28.2
unnamed: LED1.1 (K), Q1.6 (C2)
unnamed: LED2.2 (A), R32.1
unnamed: LED3.2 (A), R85.2
unnamed: LED3.1 (K), Q9.3 (C1)
unnamed: LED4.2 (A), R87.2
unnamed: LED4.1 (K), Q9.6 (C2)
unnamed: Q1.5 (B1), R27.1
unnamed: Q1.1 (E2), Q1.3 (C1)
unnamed: Q1.2 (B2), R26.1
unnamed: Q2.1 (B), R31.1
unnamed: Q2.3 (C), R32.2
unnamed: Q3.5 (B1), R68.1
unnamed: C61.1, Q3.3 (C1), Q3.6 (C2), R70.2
unnamed: Q3.2 (B2), R76.1
unnamed: C62.2, Q4.3 (D), R73.2, R78.2, R79.2
unnamed: Q4.1 (G), R71.2
unnamed: Q4.2 (S), Q5.3 (C)
unnamed: Q5.1 (B), R72.2
unnamed: C61.2, Q6.5 (B1), R75.2
unnamed: Q6.2 (B2), Q6.3 (C1), R76.2, R77.2
unnamed: Q7.4 (G), R78.1
unnamed: Q8.4 (G), R79.1
unnamed: Q9.5 (B1), R86.2
unnamed: Q9.2 (B2), R88.2
unnamed: R1.2, U1.2
unnamed: R2.2, U2.2
unnamed: R102.2, TP9.1
unnamed: R103.2, TP18.1
unnamed: R104.2, TP29.1
unnamed: R16.1, SW1.1 (A)
unnamed: C7.1, R3.2, U3.4 (V_{DD})
unnamed: C8.1, R4.2, U4.4 (V_{DD})
unnamed: R13.2, U5.5 (EN)
unnamed: R12.2, U5.6 (PH)
unnamed: R11.2, U5.7 (~SLEEP)
unnamed: U7.1 (~MR), U7.8 (~WDO)
unnamed: R14.2, U7.7 (~RESET)
unnamed: R24.1, U8.40 (PB17)
unnamed: R25.1, U8.50 (PB23)
unnamed: R36.2, U11.4 (DIN)
unnamed: R37.2, U11.5 (SCK)
unnamed: R38.2, U11.6 (~SYNC)
unnamed: R34.2, U12.8 (DIN)
unnamed: C38.1, U12.5 (EXT_CAP)
unnamed: R33.2, U12.9 (SCK)
unnamed: R40.2, U12.7 (SDO)
unnamed: R35.2, U12.10 (~SYNC)
unnamed: R45.2, U13.12 (PGOOD)
unnamed: R50.2, U14.4 (DIN)
unnamed: R51.2, U14.5 (SCK)
unnamed: R52.2, U14.6 (~SYNC)
unnamed: R48.2, U15.8 (DIN)
unnamed: C48.1, U15.5 (EXT_CAP)
unnamed: R47.2, U15.9 (SCK)
unnamed: R54.2, U15.7 (SDO)
unnamed: R49.2, U15.10 (~SYNC)
unnamed: R59.2, U16.12 (PGOOD)
unnamed: R63.2, U18.5 (EN)
unnamed: R62.2, U18.6 (PH)
unnamed: R61.2, U18.7 (~SLEEP)
unnamed: R67.2, U19.5 (EN)
unnamed: R66.2, U19.6 (PH)
unnamed: R65.2, U19.7 (~SLEEP)
unnamed: R74.1, U20.4 (~EN)
unnamed: R81.2, U20.3 (~FLG)
unnamed: R83.2, R84.1, U24.1 (REF)
unnamed: R92.2, U25.4 (DIN)
unnamed: R93.2, U25.5 (SCK)
unnamed: R94.2, U25.6 (~SYNC)
unnamed: R90.2, U26.8 (DIN)
unnamed: C79.1, U26.5 (EXT_CAP)
unnamed: R89.2, U26.9 (SCK)
unnamed: R96.2, U26.7 (SDO)
unnamed: R91.2, U26.10 (~SYNC)
unnamed: R101.2, U27.12 (PGOOD)
VAA: C39.1, C49.1, C65.1, C66.1, C67.1, C68.1, C69.1, C70.1, C80.1, J9.4, Q7.5 (D), Q8.5 (D), R18.1, R82.1, R85.1, TP11.1, TP20.1, TP23.1, TP31.1, U13.8 (VIN), U16.8 (VIN), U21.2 (VI), U22.2 (VI), U23.2 (VI), U27.8 (VIN)
