Sierra-Lobo/mtdb-hw/(commit log)

2023-06-24 exported init pdf
    [adj_buck.kicad_sch, control.kicad_sch, i_fb.kicad_sch, magnetotorqer-drive-board.kicad_sch]
2023-06-28 routing mostly complete
    [adj_buck.kicad_sch, control.kicad_sch, driver.kicad_sch, magnetotorqer-drive-board.kicad_pcb, magnetotorqer-drive-board.kicad_sch, power.kicad_sch]
2023-06-30 worked review changes
    [adj_buck.kicad_sch, control.kicad_sch, driver.kicad_sch, h_bridge.kicad_sch, i_fb.kicad_sch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]
